jaseg/yanartas-sensors/power/yanartas-pillowbox-power.kicad_pcb

## KiCad design power/yanartas-pillowbox-power.kicad_pcb (2026-11-09)

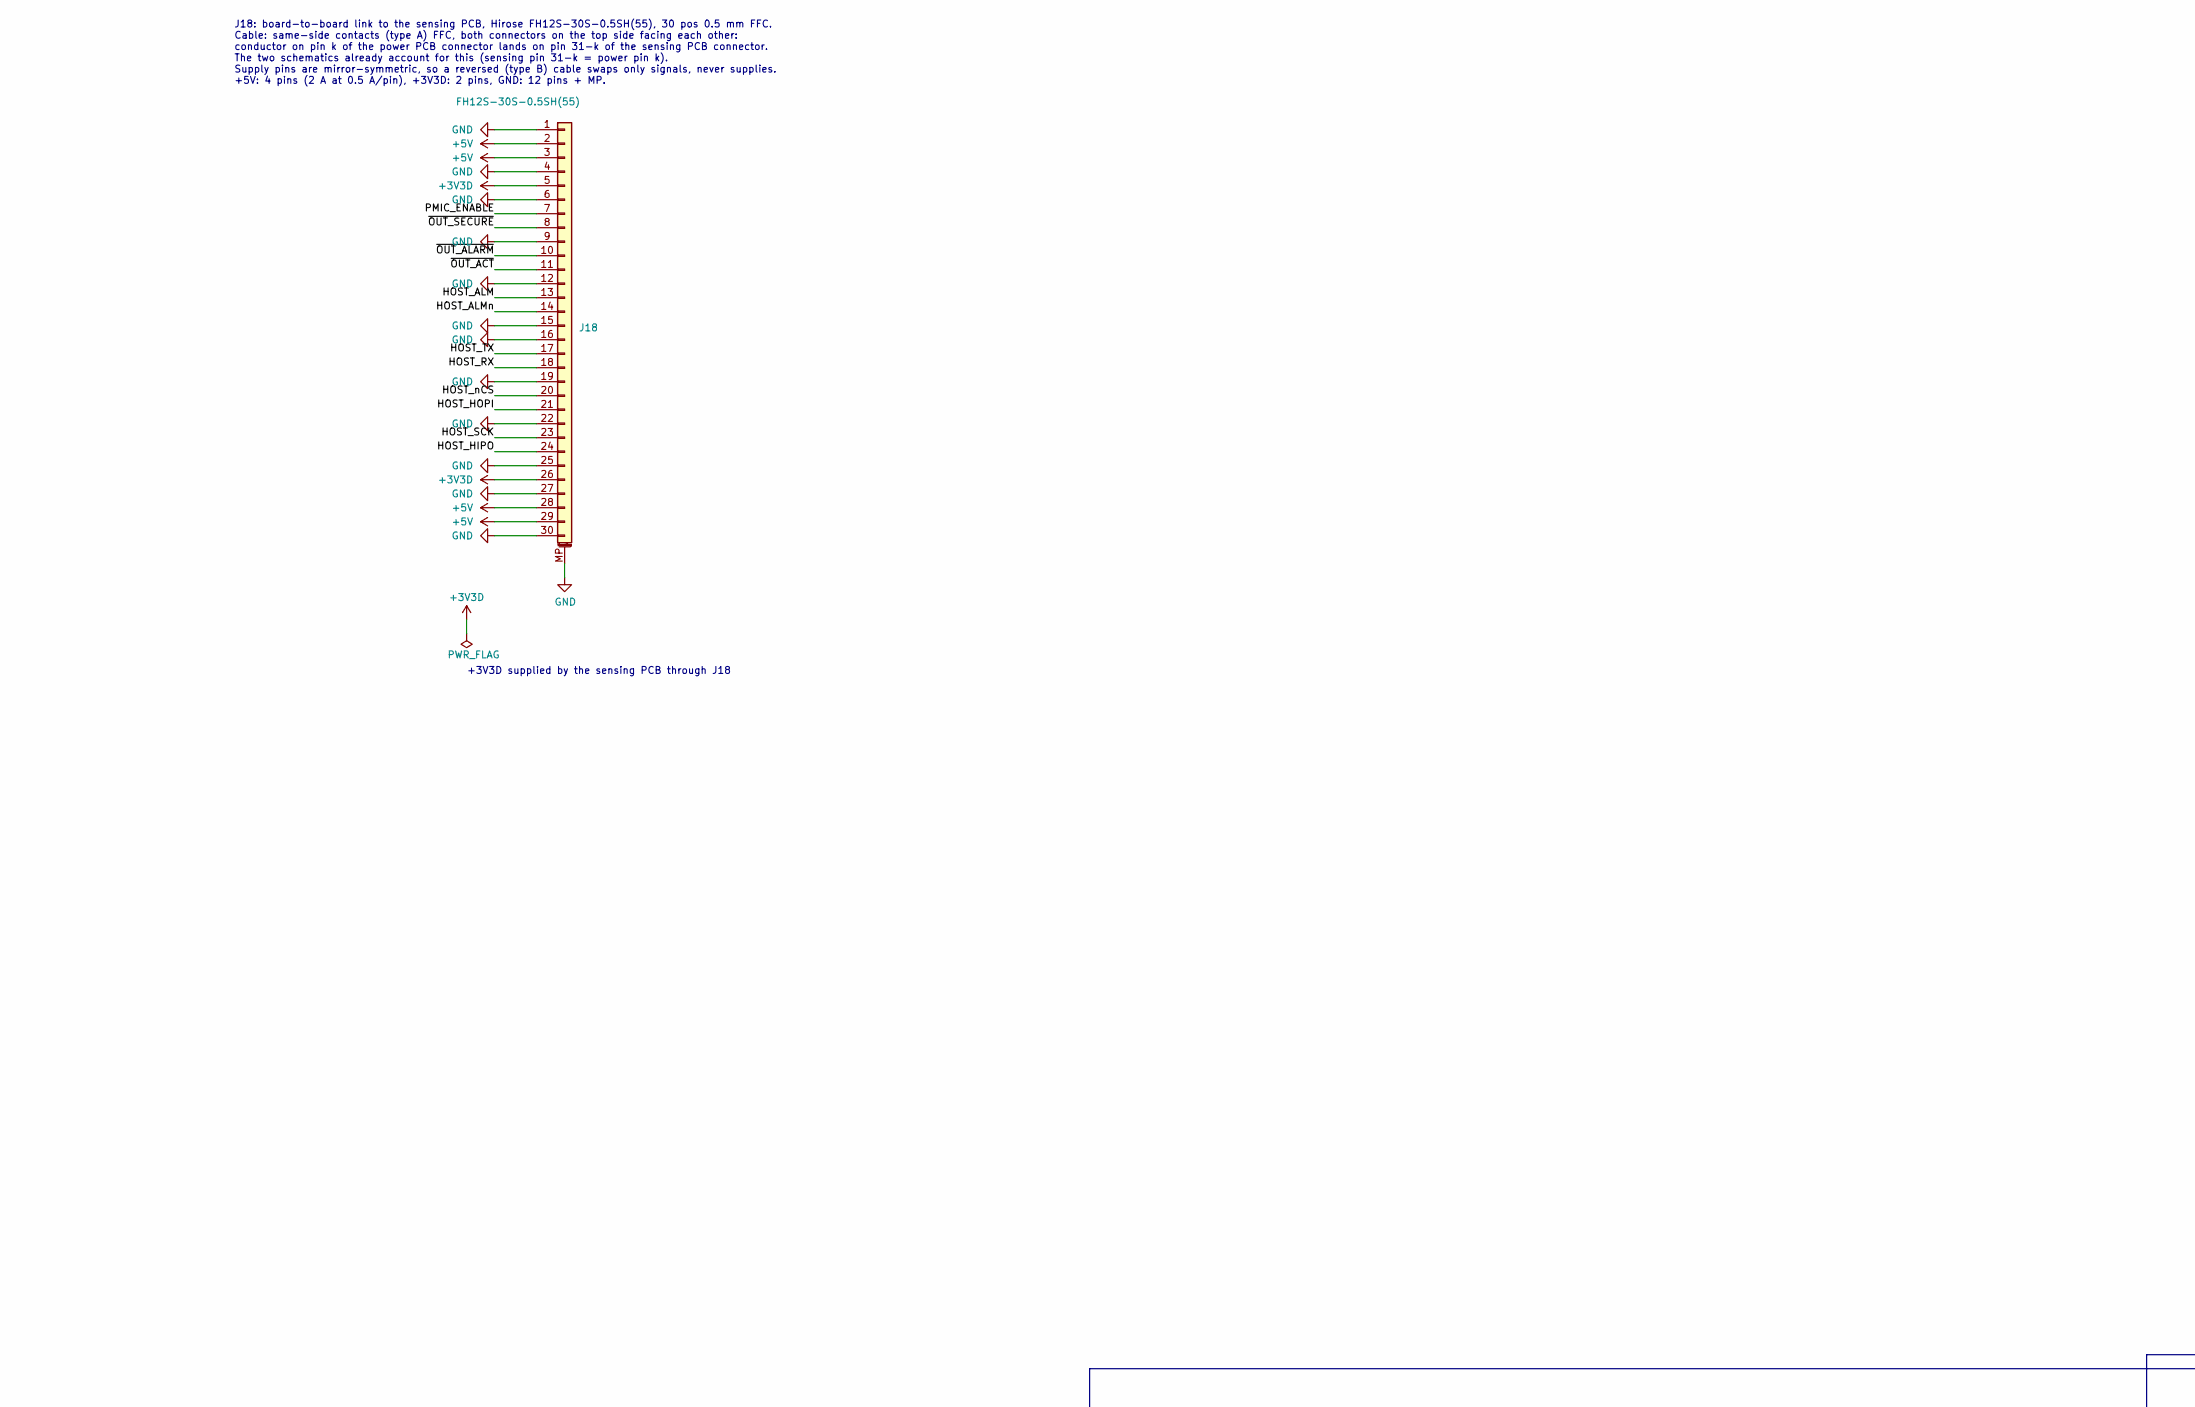
[picture p1: schematic yanartas-pillowbox-power.kicad_sch, part in row 1, column 1]

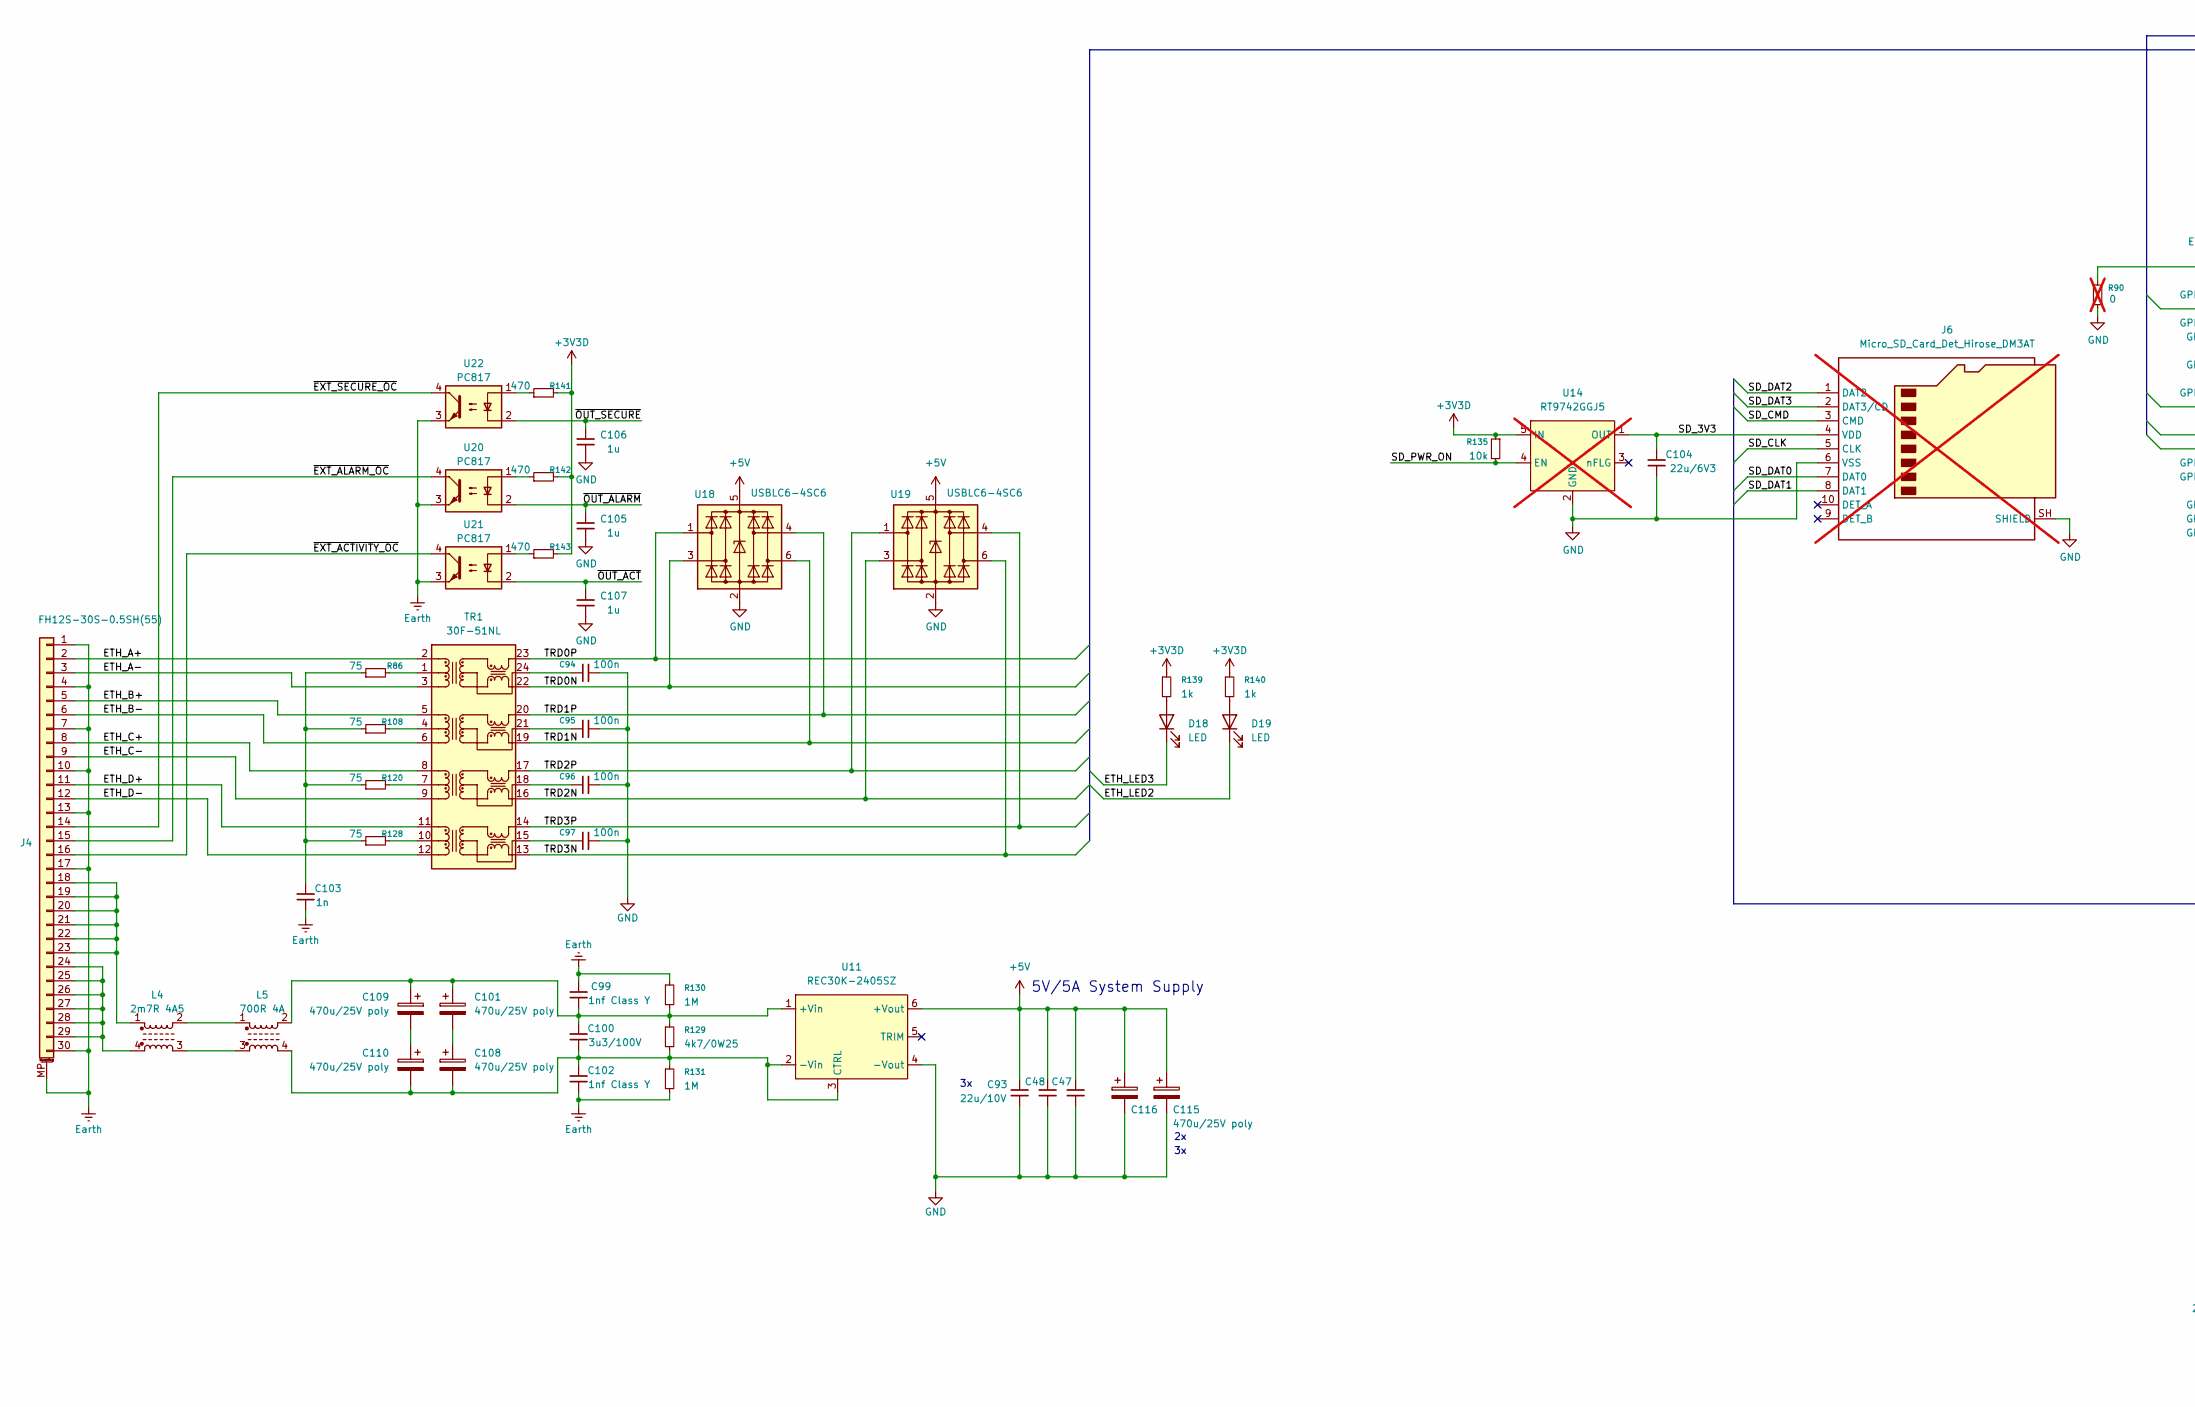
[picture p2: schematic yanartas-pillowbox-power.kicad_sch, part in row 2, column 1]

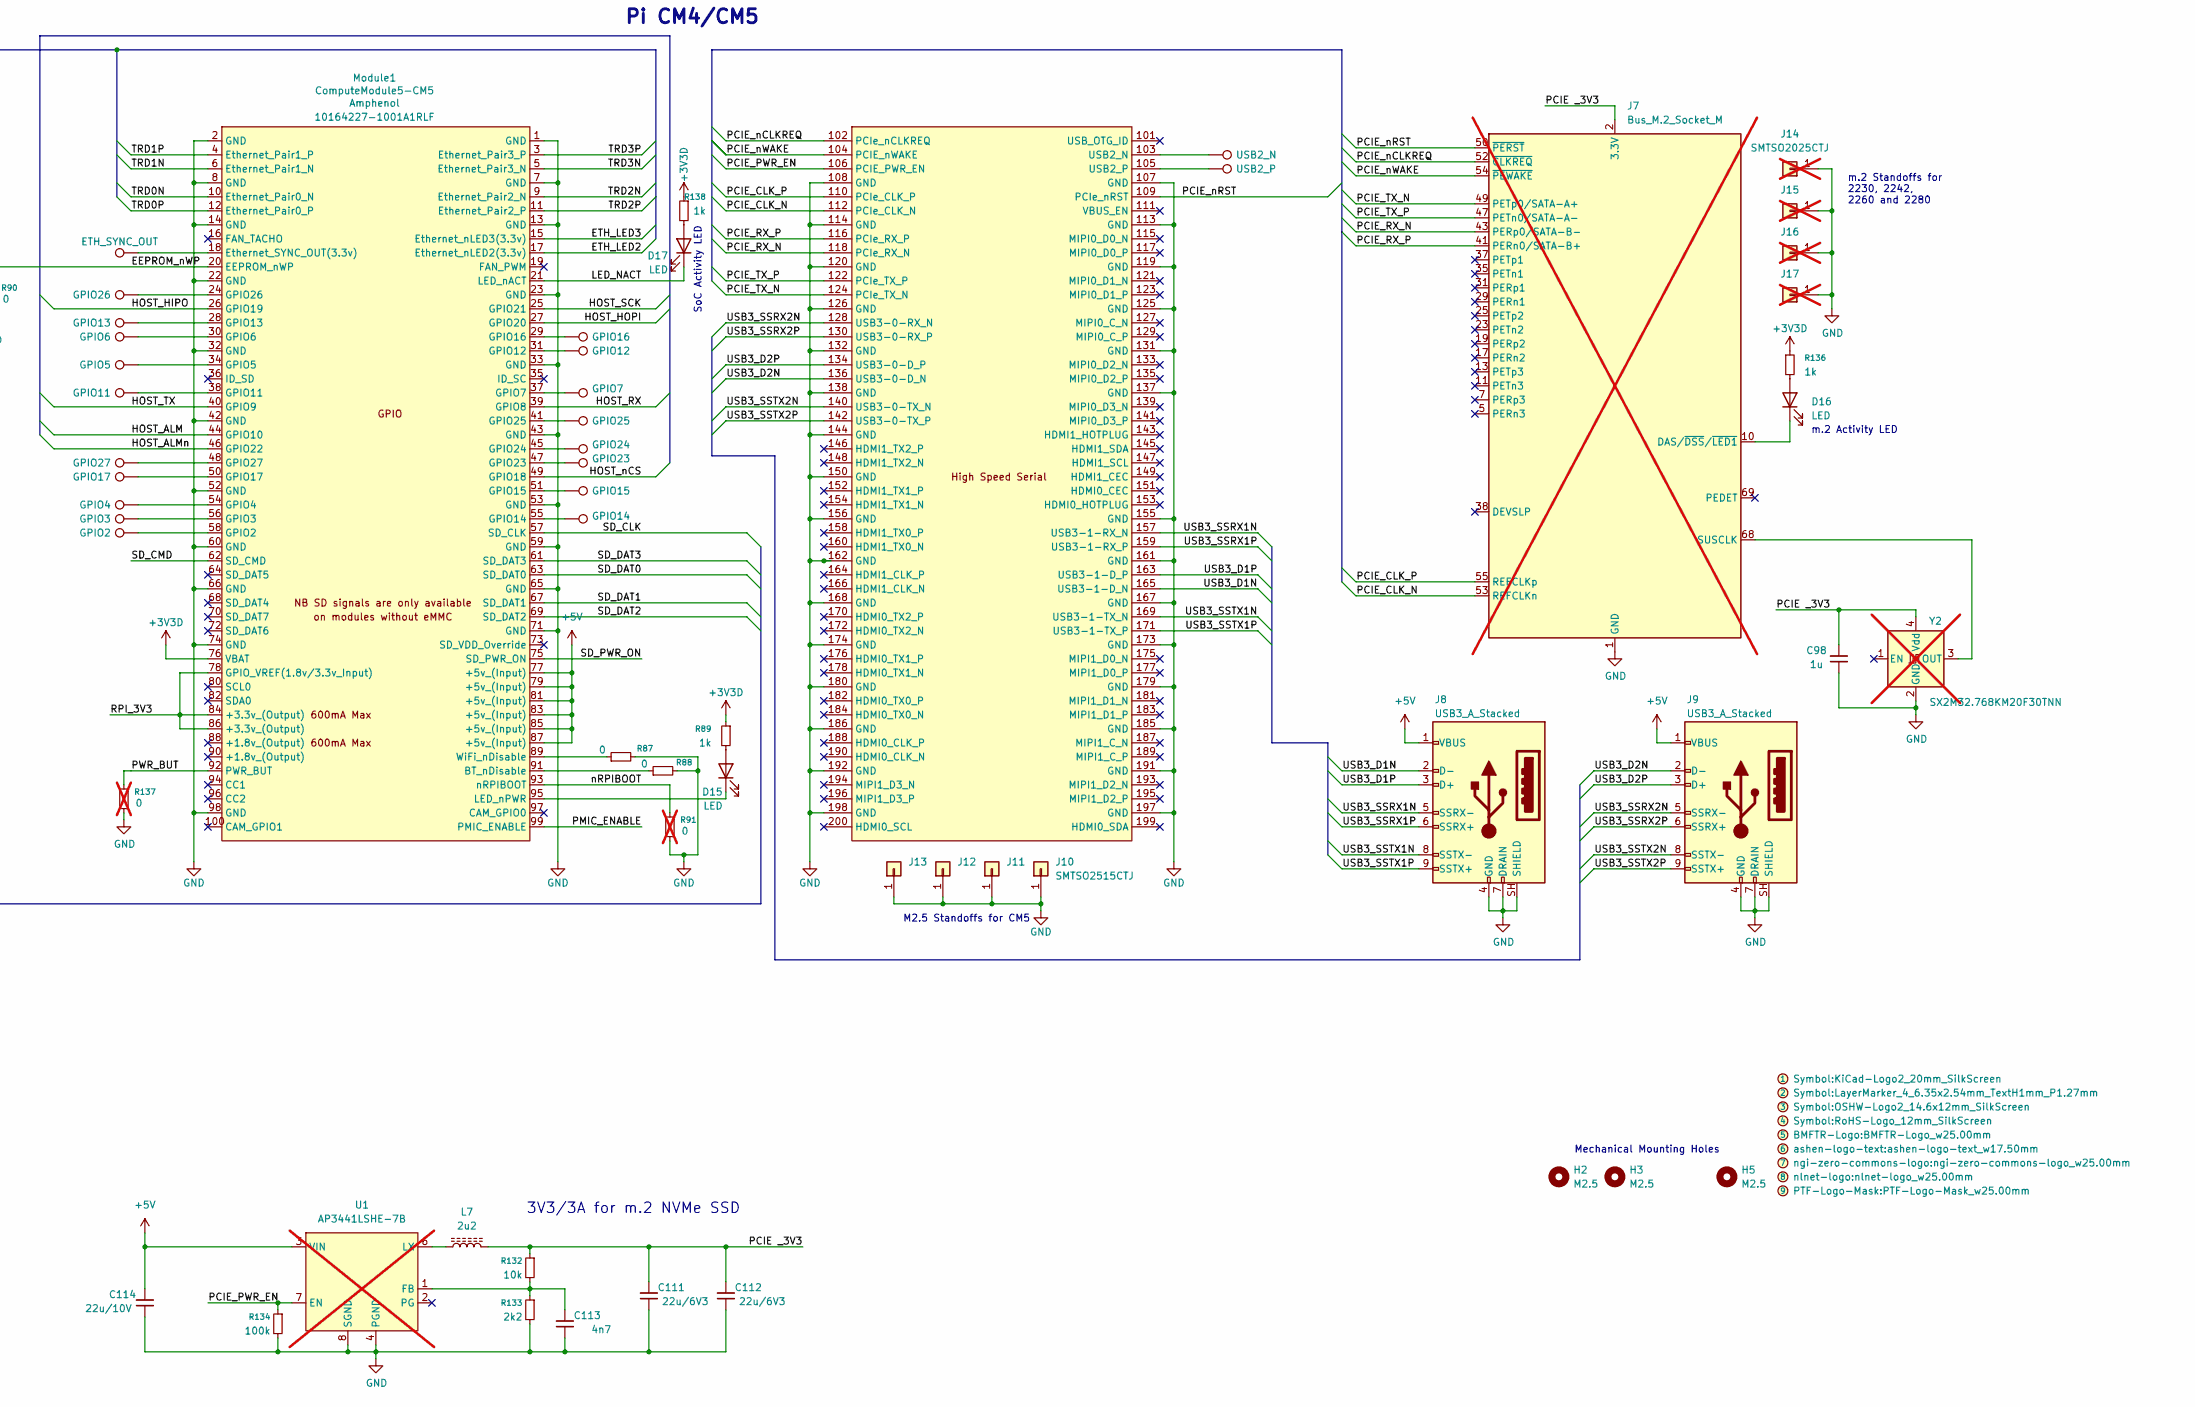
[picture p3: schematic yanartas-pillowbox-power.kicad_sch, part in row 2, column 2]

Parts:
C47, C48, C93, C114: 22u/10V; C_0805_2012Metric; LCSC C45783
C94, C95, C96, C97: 100n; C_0402_1005Metric; LCSC C1525
C98, C105, C106, C107: 1u; C_0402_1005Metric; LCSC C52923
C99, C102: 1nf Class Y; C_Rect_L13.0mm_W4.0mm_P10.00mm_FKS3_FKP3_MKS4; LCSC C361361
C100: 3u3/100V; C_1206_3216Metric; LCSC C695361
C101, C108, C109, C110, C115, C116: 470u/25V poly; CP_Radial_D10.0mm_P5.00mm; MfgPN A750MS477M1EAAE015; LCSC C696345
C103: 1n; C_0603_1608Metric; LCSC C1588
C104, C111, C112: 22u/6V3; C_0805_2012Metric; LCSC C45783
C113: 4n7; C_0402_1005Metric; LCSC C1538
D15, D16, D17, D18, D19: LED; LED_0603_1608Metric; LCSC C2290
H2, H3, H5: M2.5; MountingHole_2.7mm_M2.5; LCSC NA
J4, J18: FH12S-30S-0.5SH(55); Hirose_FH12-30S-0.5SH_1x30-1MP_P0.50mm_Horizontal; LCSC C3169607
J6: Micro_SD_Card_Det_Hirose_DM3AT; microSD_HC_Hirose_DM3AT-SF-PEJM5; MPN DM3AT-SF-PEJM5; LCSC C114218; not fitted
J7: Bus_M.2_Socket_M; CONN-SMD_MDT420M02001; LCSC C2927698; not fitted
J8, J9: USB3_A_Stacked; USB_A_Receptacle_XKB_U231-091N-4BLRA00-S; LCSC C2880618
J10, J11, J12, J13: SMTSO2515CTJ; SINHOO_SMTSO25XX; LCSC C2915629
J14, J15, J16, J17: SMTSO2025CTJ; SINHOO_SMTSO20XX; LCSC C2916321; not fitted
L4: 2m7R 4A5; EPCOS_B82723A; MPN B82723A2402N001; LCSC NA
L5: 700R 4A; TDK_ACM7060; MPN ACM7060-701-2PL-TL01; LCSC C78246
L7: 2u2; CJIANG_FXL0420; LCSC C167206
Module1: ComputeModule5-CM5; Raspberry-Pi-5-Compute-Module-A; Part Description 100 Position Connector Receptacle, Cent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; LCSC C6782225
Module2: ComputeModule5-CM5; Raspberry-Pi-5-Compute-Module-B; Part Description 100 Position Connector Receptacle, Cent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; LCSC C6782225
R86, R108, R120, R128: 75; R_0402_1005Metric; LCSC C25133
R87, R88: 0; R_0402_1005Metric; LCSC C17168
R89, R136, R138, R139, R140: 1k; R_0402_1005Metric; LCSC C11702
R90, R91, R137: 0; R_0402_1005Metric; LCSC C17168; not fitted
R129: 4k7/0W25; R_1206_3216Metric; LCSC C17936
R130, R131: 1M; R_0603_1608Metric; LCSC C22935
R132, R135: 10k; R_0402_1005Metric; LCSC C25744
R133: 2k2; R_0402_1005Metric; LCSC C25879
R134: 100k; R_0402_1005Metric; LCSC C25741
R141, R142, R143: 470; R_0402_1005Metric; LCSC C25117
TP1: GPIO27; TestPoint_Pad_D1.0mm; LCSC NA
TP2: GPIO17; TestPoint_Pad_D1.0mm; LCSC NA
TP3: GPIO4; TestPoint_Pad_D1.0mm; LCSC NA
TP4: GPIO3; TestPoint_Pad_D1.0mm; LCSC NA
TP5: GPIO2; TestPoint_Pad_D1.0mm; LCSC NA
TP6: GPIO11; TestPoint_Pad_D1.0mm; LCSC NA
TP7: GPIO5; TestPoint_Pad_D1.0mm; LCSC NA
TP8: GPIO6; TestPoint_Pad_D1.0mm; LCSC NA
TP9: GPIO13; TestPoint_Pad_D1.0mm; LCSC NA
TP10: GPIO26; TestPoint_Pad_D1.0mm; LCSC NA
TP11: ETH_SYNC_OUT; TestPoint_Pad_D1.0mm; LCSC NA
TP12: GPIO14; TestPoint_Pad_D1.0mm; LCSC NA
TP13: GPIO15; TestPoint_Pad_D1.0mm; LCSC NA
TP14: GPIO23; TestPoint_Pad_D1.0mm; LCSC NA
TP15: GPIO24; TestPoint_Pad_D1.0mm; LCSC NA
TP16: GPIO25; TestPoint_Pad_D1.0mm; LCSC NA
TP17: GPIO7; TestPoint_Pad_D1.0mm; LCSC NA
TP18: GPIO12; TestPoint_Pad_D1.0mm; LCSC NA
TP19: GPIO16; TestPoint_Pad_D1.0mm; LCSC NA
TP20: USB2_N; TestPoint_Pad_D1.0mm; LCSC NA
TP21: USB2_P; TestPoint_Pad_D1.0mm; LCSC NA
TR1: 30F-51NL; Transformer_Ethernet_YDS_30F-51NL_SO-24_7.1x15.1mm; LCSC C123168
U1: AP3441LSHE-7B; DFN-8-1EP_2x2mm_P0.5mm_EP1.05x1.75mm; LCSC C2072094; not fitted
U11: REC30K-2405SZ; RECOM_REC30K-2405SZ; LCSC NA
U14: RT9742GGJ5; SOT-23-5; Part Description Power Switch/Driver 1:1 N-Channel 1A TS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; LCSC C250547; not fitted
U18, U19: USBLC6-4SC6; SOT-23-6; LCSC C558419
U20, U21, U22: PC817; SMDIP-4_W7.62mm; LCSC C41807
Y2: SX2M32.768KM20F30TNN; Crystal_SMD_2520-4Pin_2.5x2.0mm; LCSC C2901603; not fitted

Connections:
+3V3D: J18.5, J18.26, Module1.76 (VBAT), R89.1, R135.1, R136.1, R138.1, R139.1, R140.1, R141.2, R142.2, R143.2, U14.5 (IN)
+5V: C47.2, C48.2, C93.2, C114.2, C115.1, C116.1, J8.1 (VBUS), J9.1 (VBUS), J18.2, J18.3, J18.28, J18.29, Module1.77 (+5v_(Input)), Module1.79 (+5v_(Input)), Module1.81 (+5v_(Input)), Module1.83 (+5v_(Input)), Module1.85 (+5v_(Input)), Module1.87 (+5v_(Input)), U1.3 (VIN), U11.6 (+Vout), U18.5 (VBUS), U19.5 (VBUS)
/EEPROM_nWP: Module1.20 (EEPROM_nWP), R90.2
/ETH_A+: J4.2, TR1.2 (TD1+)
/ETH_A-: J4.3, TR1.3 (TD1-)
/ETH_B+: J4.5, TR1.5 (TD2+)
/ETH_B-: J4.6, TR1.6 (TD2-)
/ETH_C+: J4.8, TR1.8 (TD3+)
/ETH_C-: J4.9, TR1.9 (TD3-)
/ETH_D+: J4.11, TR1.11 (TD4+)
/ETH_D-: J4.12, TR1.12 (TD4-)
/ETH_LED2: D19.1 (K), Module1.17 (Ethernet_nLED2(3.3v))
/ETH_LED3: D18.1 (K), Module1.15 (Ethernet_nLED3(3.3v))
/HOST_ALM: J18.13, Module1.44 (GPIO10)
/HOST_ALMn: J18.14, Module1.46 (GPIO22)
/HOST_HIPO: J18.24, Module1.26 (GPIO19)
/HOST_HOPI: J18.21, Module1.27 (GPIO20)
/HOST_RX: J18.18, Module1.39 (GPIO8)
/HOST_SCK: J18.23, Module1.25 (GPIO21)
/HOST_TX: J18.17, Module1.40 (GPIO9)
/HOST_nCS: J18.20, Module1.49 (GPIO18)
/LED_NACT: D17.1 (K), Module1.21 (LED_nACT)
/PCIE _3V3: C98.2, C111.2, C112.2, J7.2 (3.3V), J7.4 (3.3V), J7.12 (3.3V), J7.14 (3.3V), J7.16 (3.3V), J7.18 (3.3V), J7.70 (3.3V), J7.72 (3.3V), J7.74 (3.3V), L7.2, R132.1, Y2.4 (Vdd)
/PCIE_CLK_N: J7.53 (REFCLKn), Module2.112 (PCIe_CLK_N)
/PCIE_CLK_P: J7.55 (REFCLKp), Module2.110 (PCIe_CLK_P)
/PCIE_PWR_EN: Module2.106 (PCIE_PWR_EN), R134.1, U1.7 (EN)
/PCIE_RX_N: J7.43 (PERp0/SATA-B-), Module2.118 (PCIe_RX_N)
/PCIE_RX_P: J7.41 (PERn0/SATA-B+), Module2.116 (PCIe_RX_P)
/PCIE_TX_N: J7.49 (PETp0/SATA-A+), Module2.124 (PCIe_TX_N)
/PCIE_TX_P: J7.47 (PETn0/SATA-A-), Module2.122 (PCIe_TX_P)
/PCIE_nCLKREQ: J7.52 (~CLKREQ), Module2.102 (PCIe_nCLKREQ)
/PCIE_nRST: J7.50 (~PERST), Module2.109 (PCIe_nRST)
/PCIE_nWAKE: J7.54 (~PEWAKE), Module2.104 (PCIE_nWAKE)
/PMIC_ENABLE: J18.7, Module1.99 (PMIC_ENABLE)
/PWR_BUT: Module1.92 (PWR_BUT), R137.2
/RPI_3V3: Module1.78 (GPIO_VREF(1.8v/3.3v_Input)), Module1.84 (+3.3v_(Output)), Module1.86 (+3.3v_(Output))
/SD_3V3: C104.2, J6.4 (VDD), U14.1 (OUT)
/SD_CLK: J6.5 (CLK), Module1.57 (SD_CLK)
/SD_CMD: J6.3 (CMD), Module1.62 (SD_CMD)
/SD_DAT0: J6.7 (DAT0), Module1.63 (SD_DAT0)
/SD_DAT1: J6.8 (DAT1), Module1.67 (SD_DAT1)
/SD_DAT2: J6.1 (DAT2), Module1.69 (SD_DAT2)
/SD_DAT3: J6.2 (DAT3/CD), Module1.61 (SD_DAT3)
/SD_PWR_ON: Module1.75 (SD_PWR_ON), R135.2, U14.4 (EN)
/TRD0N: Module1.10 (Ethernet_Pair0_N), TR1.22 (MX1-), U18.3 (I/O2)
/TRD0P: Module1.12 (Ethernet_Pair0_P), TR1.23 (MX1+), U18.1 (I/O1)
/TRD1N: Module1.6 (Ethernet_Pair1_N), TR1.19 (MX2-), U18.6 (I/O4)
/TRD1P: Module1.4 (Ethernet_Pair1_P), TR1.20 (MX2+), U18.4 (I/O3)
/TRD2N: Module1.9 (Ethernet_Pair2_N), TR1.16 (MX3-), U19.3 (I/O2)
/TRD2P: Module1.11 (Ethernet_Pair2_P), TR1.17 (MX3+), U19.1 (I/O1)
/TRD3N: Module1.5 (Ethernet_Pair3_N), TR1.13 (MX4-), U19.6 (I/O4)
/TRD3P: Module1.3 (Ethernet_Pair3_P), TR1.14 (MX4+), U19.4 (I/O3)
/USB3_D1N: J8.2 (D-), Module2.165 (USB3-1-D_N)
/USB3_D1P: J8.3 (D+), Module2.163 (USB3-1-D_P)
/USB3_D2N: J9.2 (D-), Module2.136 (USB3-0-D_N)
/USB3_D2P: J9.3 (D+), Module2.134 (USB3-0-D_P)
/USB3_SSRX1N: J8.5 (SSRX-), Module2.157 (USB3-1-RX_N)
/USB3_SSRX1P: J8.6 (SSRX+), Module2.159 (USB3-1-RX_P)
/USB3_SSRX2N: J9.5 (SSRX-), Module2.128 (USB3-0-RX_N)
/USB3_SSRX2P: J9.6 (SSRX+), Module2.130 (USB3-0-RX_P)
/USB3_SSTX1N: J8.8 (SSTX-), Module2.169 (USB3-1-TX_N)
/USB3_SSTX1P: J8.9 (SSTX+), Module2.171 (USB3-1-TX_P)
/USB3_SSTX2N: J9.8 (SSTX-), Module2.140 (USB3-0-TX_N)
/USB3_SSTX2P: J9.9 (SSTX+), Module2.142 (USB3-0-TX_P)
/nRPIBOOT: Module1.93 (nRPIBOOT), R91.2
/~EXT_ACTIVITY_OC: J4.16, U21.4
/~EXT_ALARM_OC: J4.15, U20.4
/~EXT_SECURE_OC: J4.14, U22.4
/~OUT_ACT: C107.2, J18.11, U21.2
/~OUT_ALARM: C105.2, J18.10, U20.2
/~OUT_SECURE: C106.2, J18.8, U22.2
GND: C47.1, C48.1, C93.1, C94.2, C95.2, C96.2, C97.2, C98.1, C104.1, C105.1, C106.1, C107.1, C111.1, C112.1, C113.1, C114.1, C115.2, C116.2, J6.6 (VSS), J6.SH (SHIELD), J7.1 (GND), J7.3 (GND), J7.9 (GND), J7.15 (GND), J7.21 (GND), J7.27 (GND), J7.33 (GND), J7.39 (GND), J7.45 (GND), J7.51 (GND), J7.57 (GND), J7.71 (GND), J7.73 (GND), J7.75 (GND), J8.4 (GND), J8.7 (DRAIN), J8.SH (SHIELD), J9.4 (GND), J9.7 (DRAIN), J9.SH (SHIELD), J10.1 (Pin_1_1), J11.1 (Pin_1_1), J12.1 (Pin_1_1), J13.1 (Pin_1_1), J14.1 (Pin_1_1), J15.1 (Pin_1_1), J16.1 (Pin_1_1), J17.1 (Pin_1_1), J18.1, J18.4, J18.6, J18.9, J18.12, J18.15, J18.16, J18.19, J18.22, J18.25, J18.27, J18.30, J18.MP (MountPin), Module1.1 (GND), Module1.2 (GND), Module1.7 (GND), Module1.8 (GND), Module1.13 (GND), Module1.14 (GND), Module1.22 (GND), Module1.23 (GND), Module1.32 (GND), Module1.33 (GND), Module1.42 (GND), Module1.43 (GND), Module1.52 (GND), Module1.53 (GND), Module1.59 (GND), Module1.60 (GND), Module1.65 (GND), Module1.66 (GND), Module1.71 (GND), Module1.74 (GND), Module1.98 (GND), Module2.107 (GND), Module2.108 (GND), Module2.113 (GND), Module2.114 (GND), Module2.119 (GND), Module2.120 (GND), Module2.125 (GND), Module2.126 (GND), Module2.131 (GND), Module2.132 (GND), Module2.137 (GND), Module2.138 (GND), Module2.144 (GND), Module2.150 (GND), Module2.155 (GND), Module2.156 (GND), Module2.161 (GND), Module2.162 (GND), Module2.167 (GND), Module2.168 (GND), Module2.173 (GND), Module2.174 (GND), Module2.179 (GND), Module2.180 (GND), Module2.185 (GND), Module2.186 (GND), Module2.191 (GND), Module2.192 (GND), Module2.197 (GND), Module2.198 (GND), R87.2, R88.2, R90.1, R91.1, R133.2, R134.2, R137.1, U1.4 (PGND), U1.8 (SGND), U1.9 (PAD), U11.4 (-Vout), U14.2 (GND), U18.2 (GND), U19.2 (GND), Y2.2 (GND)
unnamed: C94.1, TR1.24 (CT)
unnamed: C95.1, TR1.21 (CT)
unnamed: C96.1, TR1.18 (CT)
unnamed: C97.1, TR1.15 (CT)
unnamed: C101.2, C108.1
unnamed: C103.2, R86.1, R108.1, R120.1, R128.1
unnamed: C109.2, C110.1
unnamed: D15.2 (A), R89.2
unnamed: D15.1 (K), Module1.95 (LED_nPWR)
unnamed: D16.2 (A), R136.2
unnamed: D16.1 (K), J7.10 (DAS/~DSS/~LED1)
unnamed: D17.2 (A), R138.2
unnamed: D18.2 (A), R139.2
unnamed: D19.2 (A), R140.2
unnamed: J7.68 (SUSCLK), Y2.3 (OUT)
unnamed: L4.2, L5.1
unnamed: L4.3, L5.3
unnamed: Module1.91 (BT_nDisable), R88.1
unnamed: Module1.18 (Ethernet_SYNC_OUT(3.3v)), TP11.1 (1_1)
unnamed: Module1.58 (GPIO2), TP5.1 (1_1)
unnamed: Module1.56 (GPIO3), TP4.1 (1_1)
unnamed: Module1.54 (GPIO4), TP3.1 (1_1)
unnamed: Module1.34 (GPIO5), TP7.1 (1_1)
unnamed: Module1.30 (GPIO6), TP8.1 (1_1)
unnamed: Module1.37 (GPIO7), TP17.1 (1_1)
unnamed: Module1.38 (GPIO11), TP6.1 (1_1)
unnamed: Module1.31 (GPIO12), TP18.1 (1_1)
unnamed: Module1.28 (GPIO13), TP9.1 (1_1)
unnamed: Module1.55 (GPIO14), TP12.1 (1_1)
unnamed: Module1.51 (GPIO15), TP13.1 (1_1)
unnamed: Module1.29 (GPIO16), TP19.1 (1_1)
unnamed: Module1.50 (GPIO17), TP2.1 (1_1)
unnamed: Module1.47 (GPIO23), TP14.1 (1_1)
unnamed: Module1.45 (GPIO24), TP15.1 (1_1)
unnamed: Module1.41 (GPIO25), TP16.1 (1_1)
unnamed: Module1.24 (GPIO26), TP10.1 (1_1)
unnamed: Module1.48 (GPIO27), TP1.1 (1_1)
unnamed: Module1.89 (WiFi_nDisable), R87.1
unnamed: Module2.103 (USB2_N), TP20.1 (1_1)
unnamed: Module2.105 (USB2_P), TP21.1 (1_1)
unnamed: R86.2, TR1.1 (CT)
unnamed: R108.2, TR1.4 (CT)
unnamed: R120.2, TR1.7 (CT)
unnamed: R128.2, TR1.10 (CT)
unnamed: R141.1, U22.1
unnamed: R142.1, U20.1
unnamed: R143.1, U21.1
unnamed: C113.2, R132.2, R133.1, U1.1 (FB)
unnamed: L7.1, U1.6 (LX)
unnamed: C99.1, C100.2, C101.1, C109.1, L5.2, R129.1, R130.2, U11.1 (+Vin)
unnamed: C100.1, C102.2, C108.2, C110.2, L5.4, R129.2, R131.1, U11.2 (-Vin), U11.3 (CTRL)

Notes on the sheet:
m.2 Standoffs for 2230, 2242, 2260 and 2280
SoC Activity LED
Pi CM4/CM5
M2.5 Standoffs for CM5
5V/5A System Supply
Mechanical Mounting Holes
m.2 Activity LED
3V3/3A for m.2 NVMe SSD
J18: board-to-board link to the sensing PCB, Hirose FH12S-30S-0.5SH(55), 30 pos 0.5 mm FFC. Cable: same-side contacts (type A) FFC, both connectors on the top side facing each other: conductor on pin k of the power PCB connector lands on pin 31-k of the sensing PCB connector. The two schematics alr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
+3V3D supplied by the sensing PCB through J18

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
Board: 2 copper layers, 107 parts (6 on the bottom side), 117 nets, no tracks yet.
