jaseg/yanartas-sensors/sensing/yanartas-pillowbox-sensing.kicad_pcb

## KiCad design sensing/yanartas-pillowbox-sensing.kicad_pcb (2026-11-09)

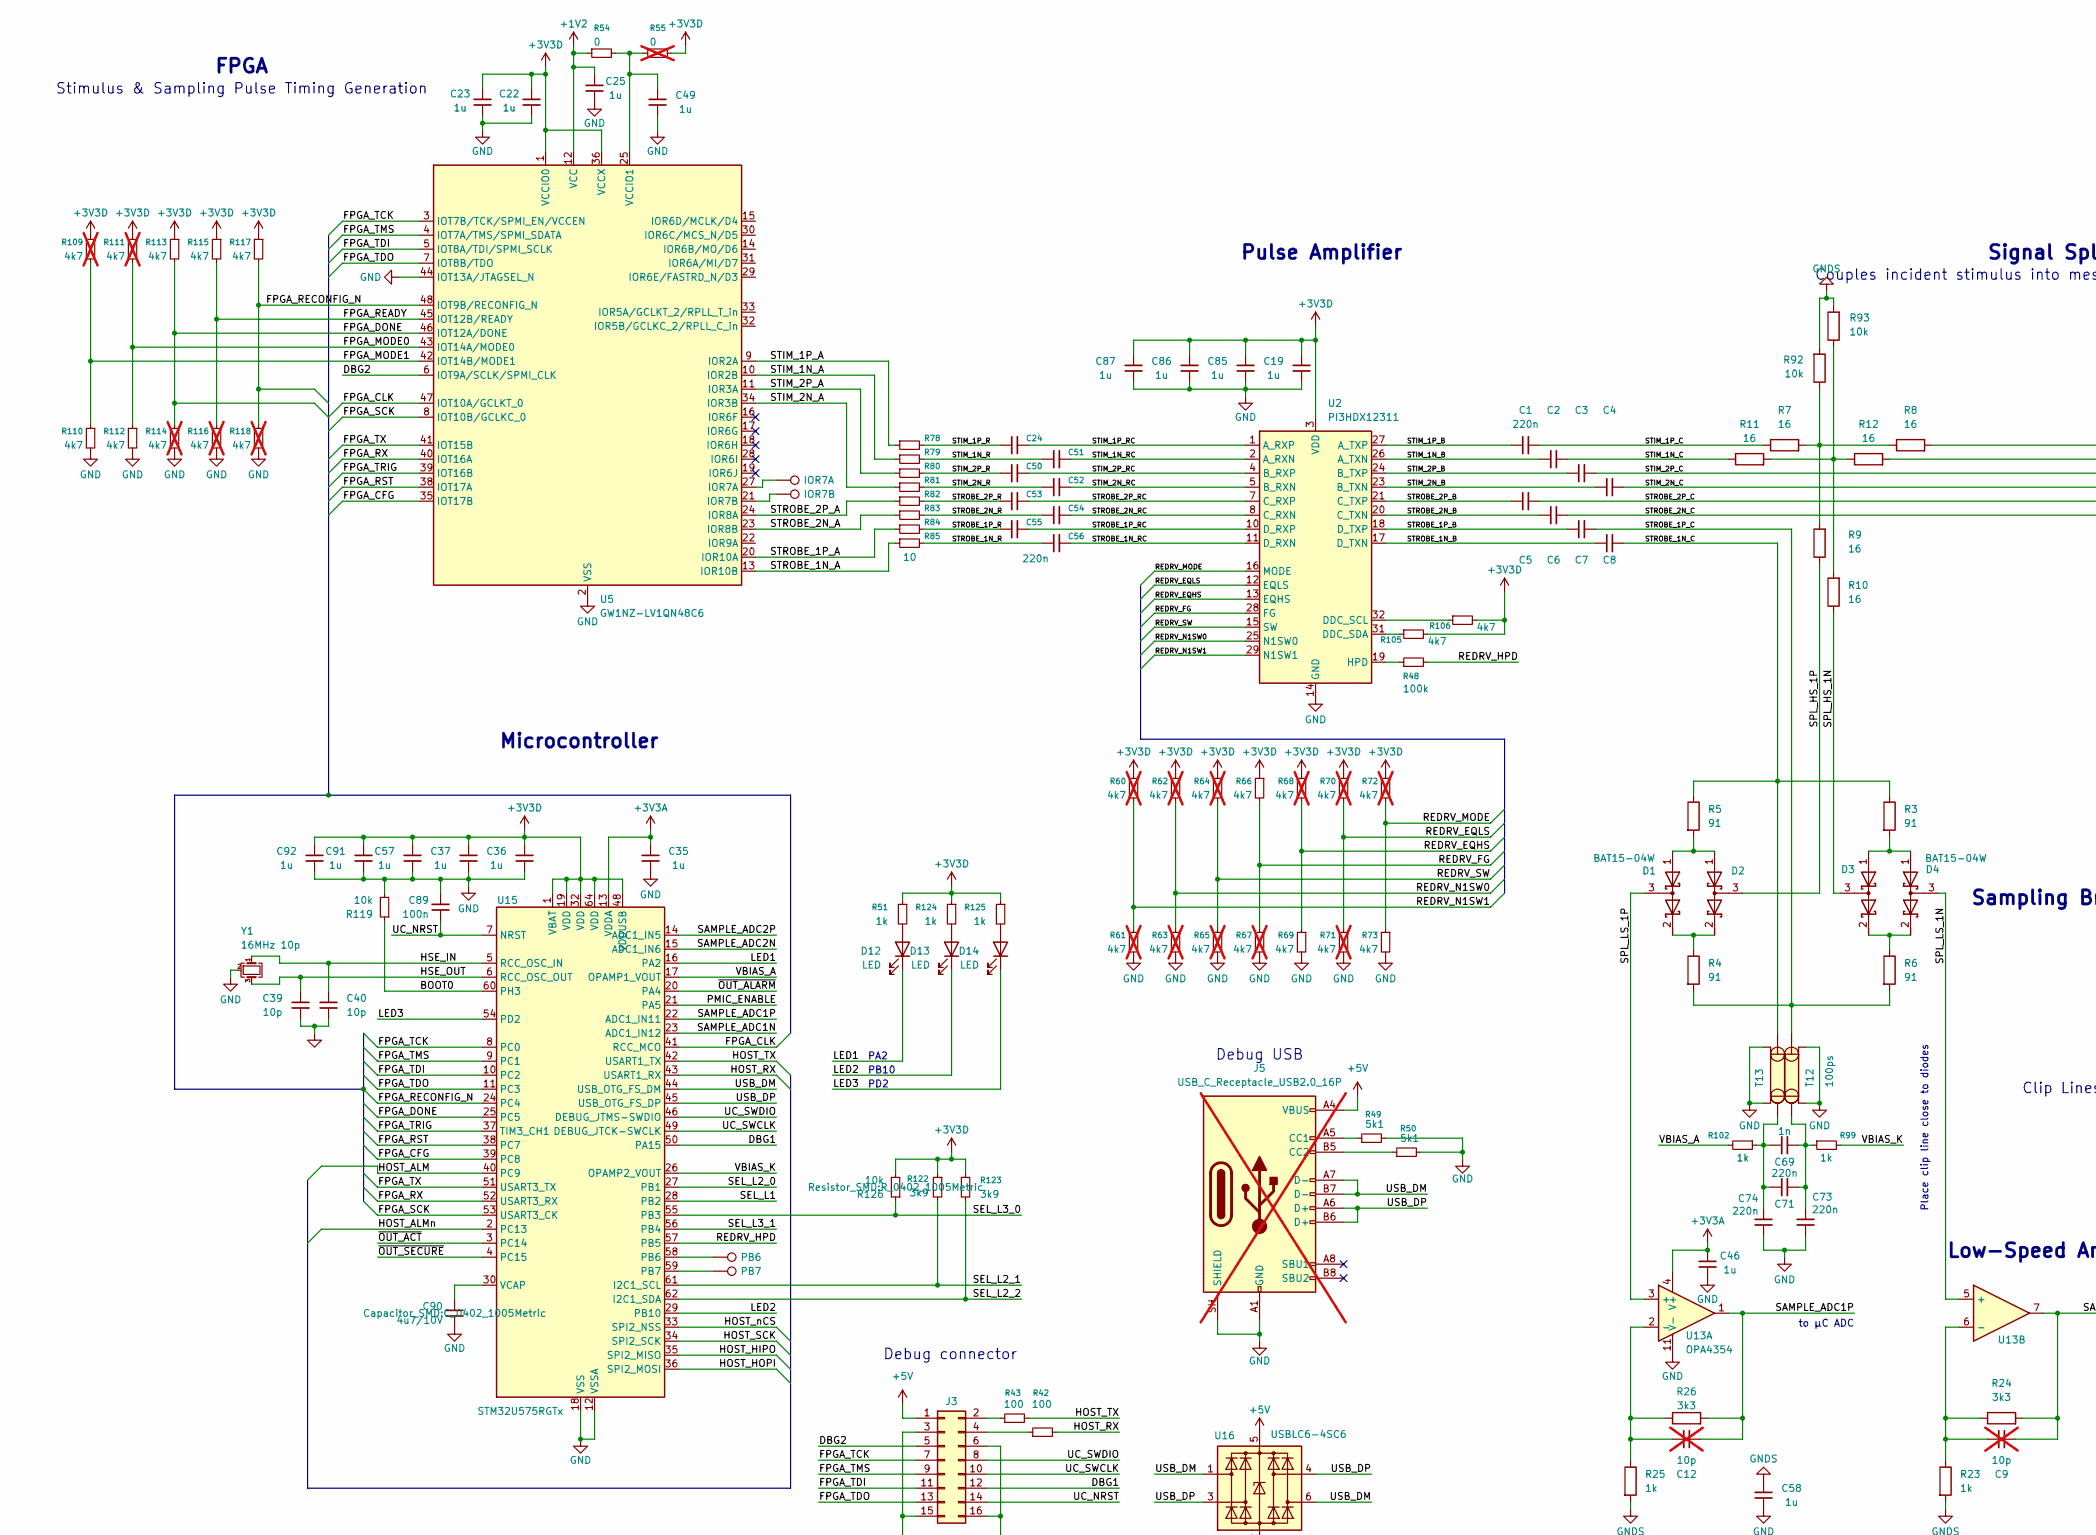
[picture p4: schematic yanartas-pillowbox-sensing.kicad_sch, part in row 1, column 1]

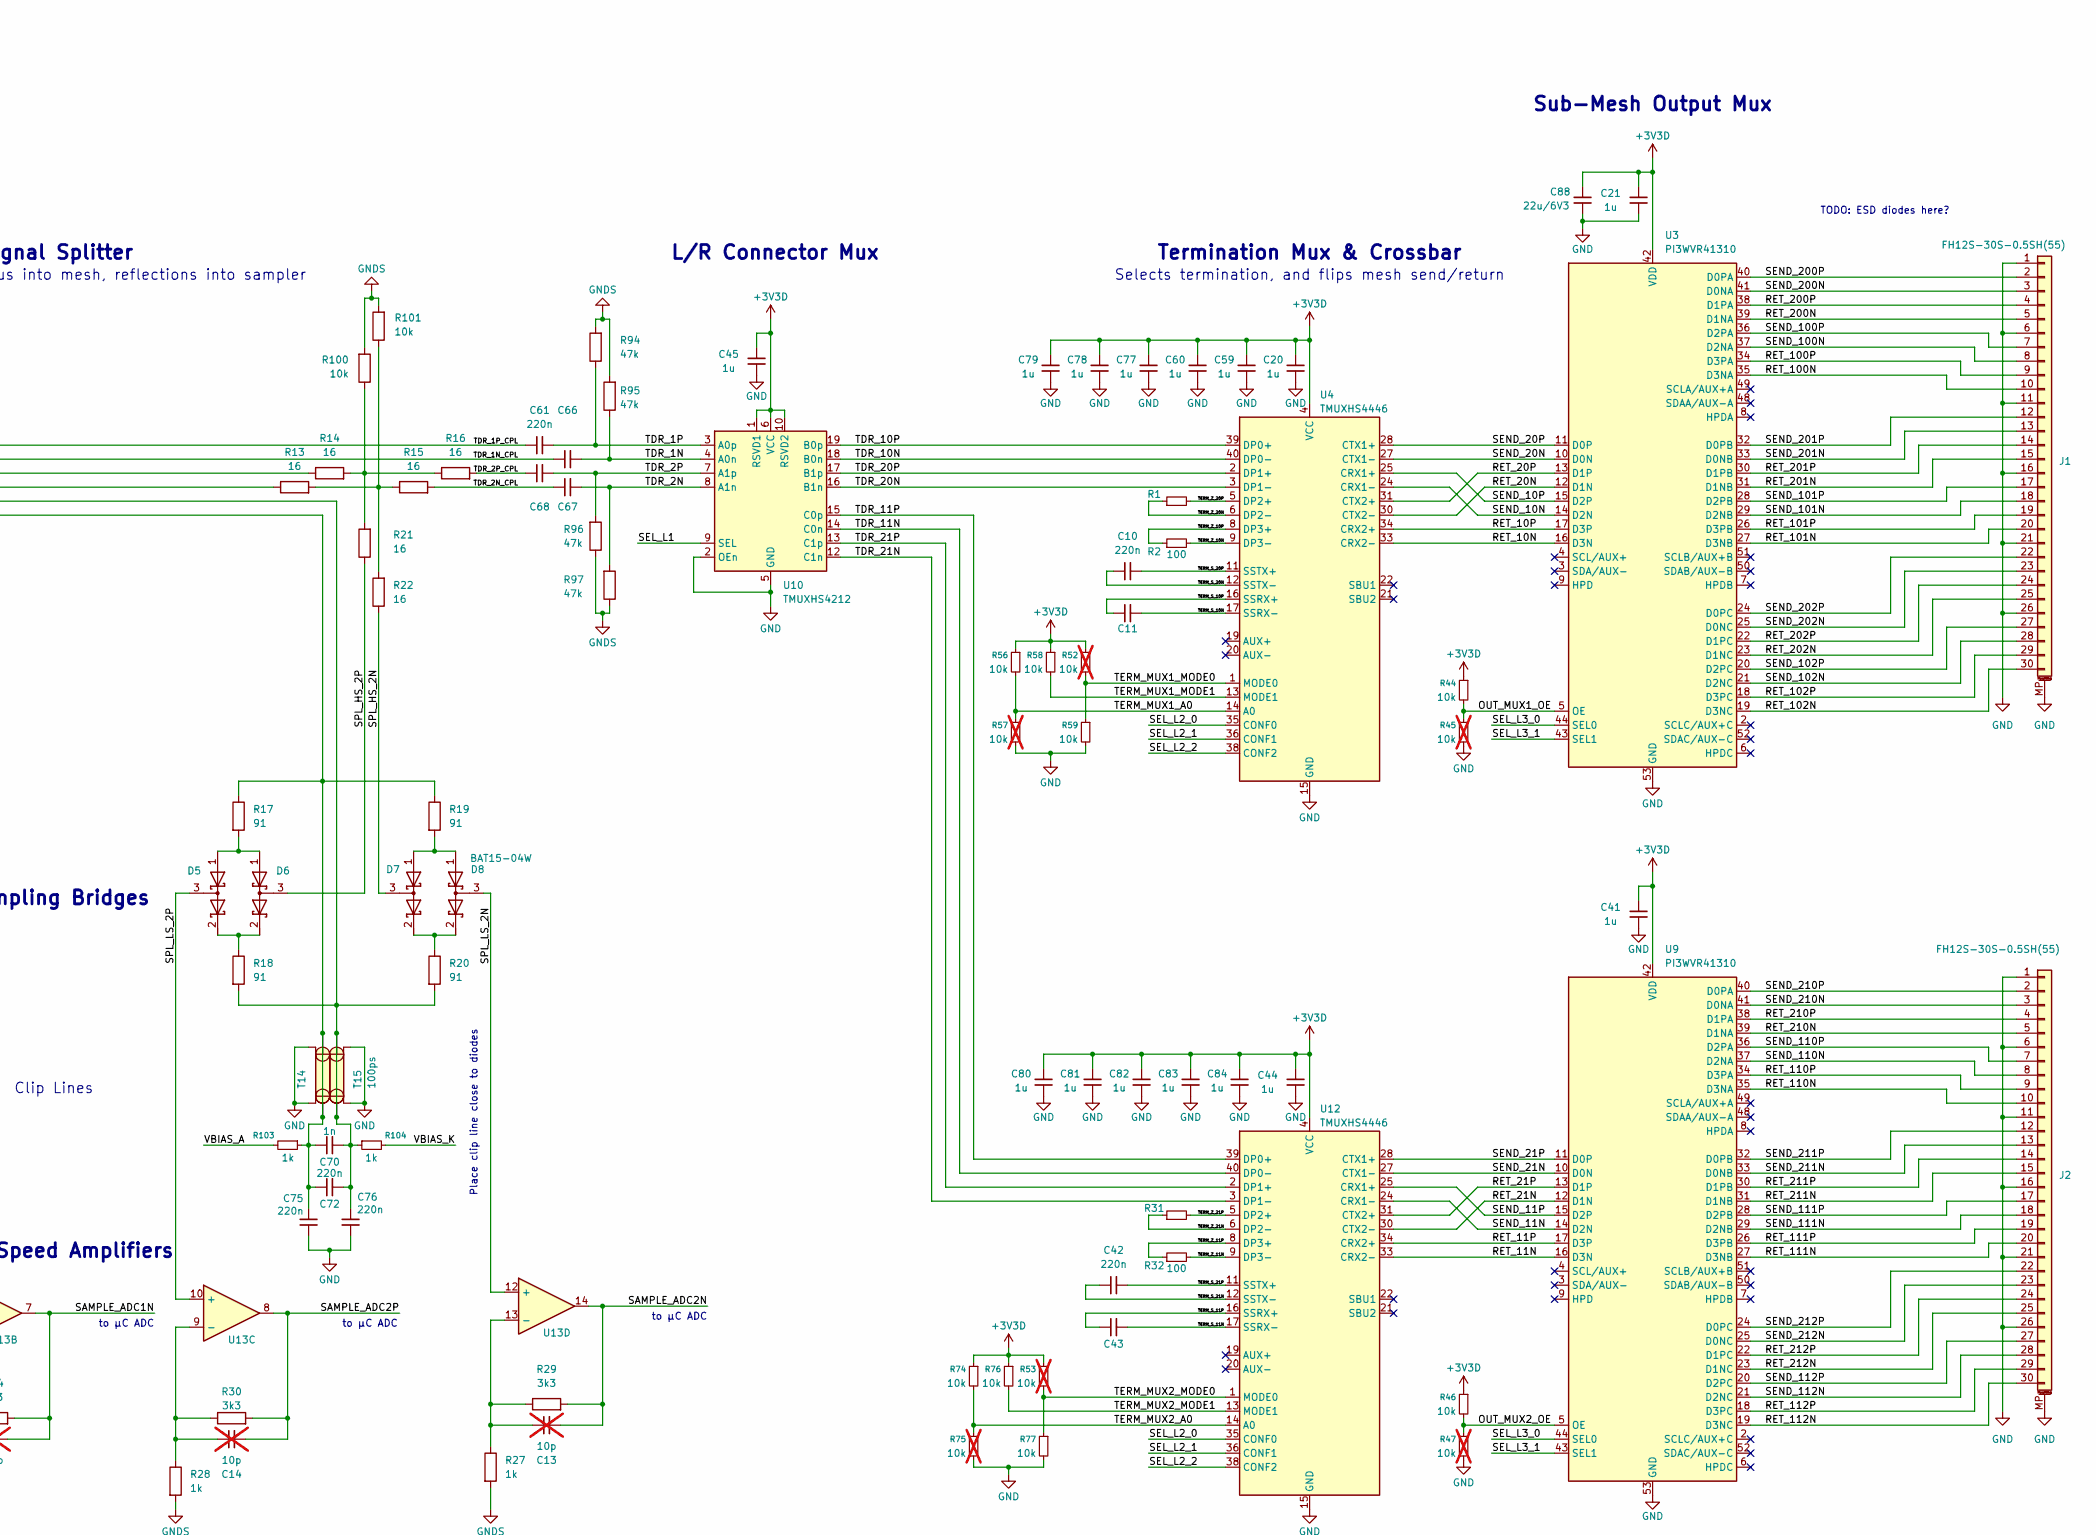
[picture p5: schematic yanartas-pillowbox-sensing.kicad_sch, part in row 1, column 2]

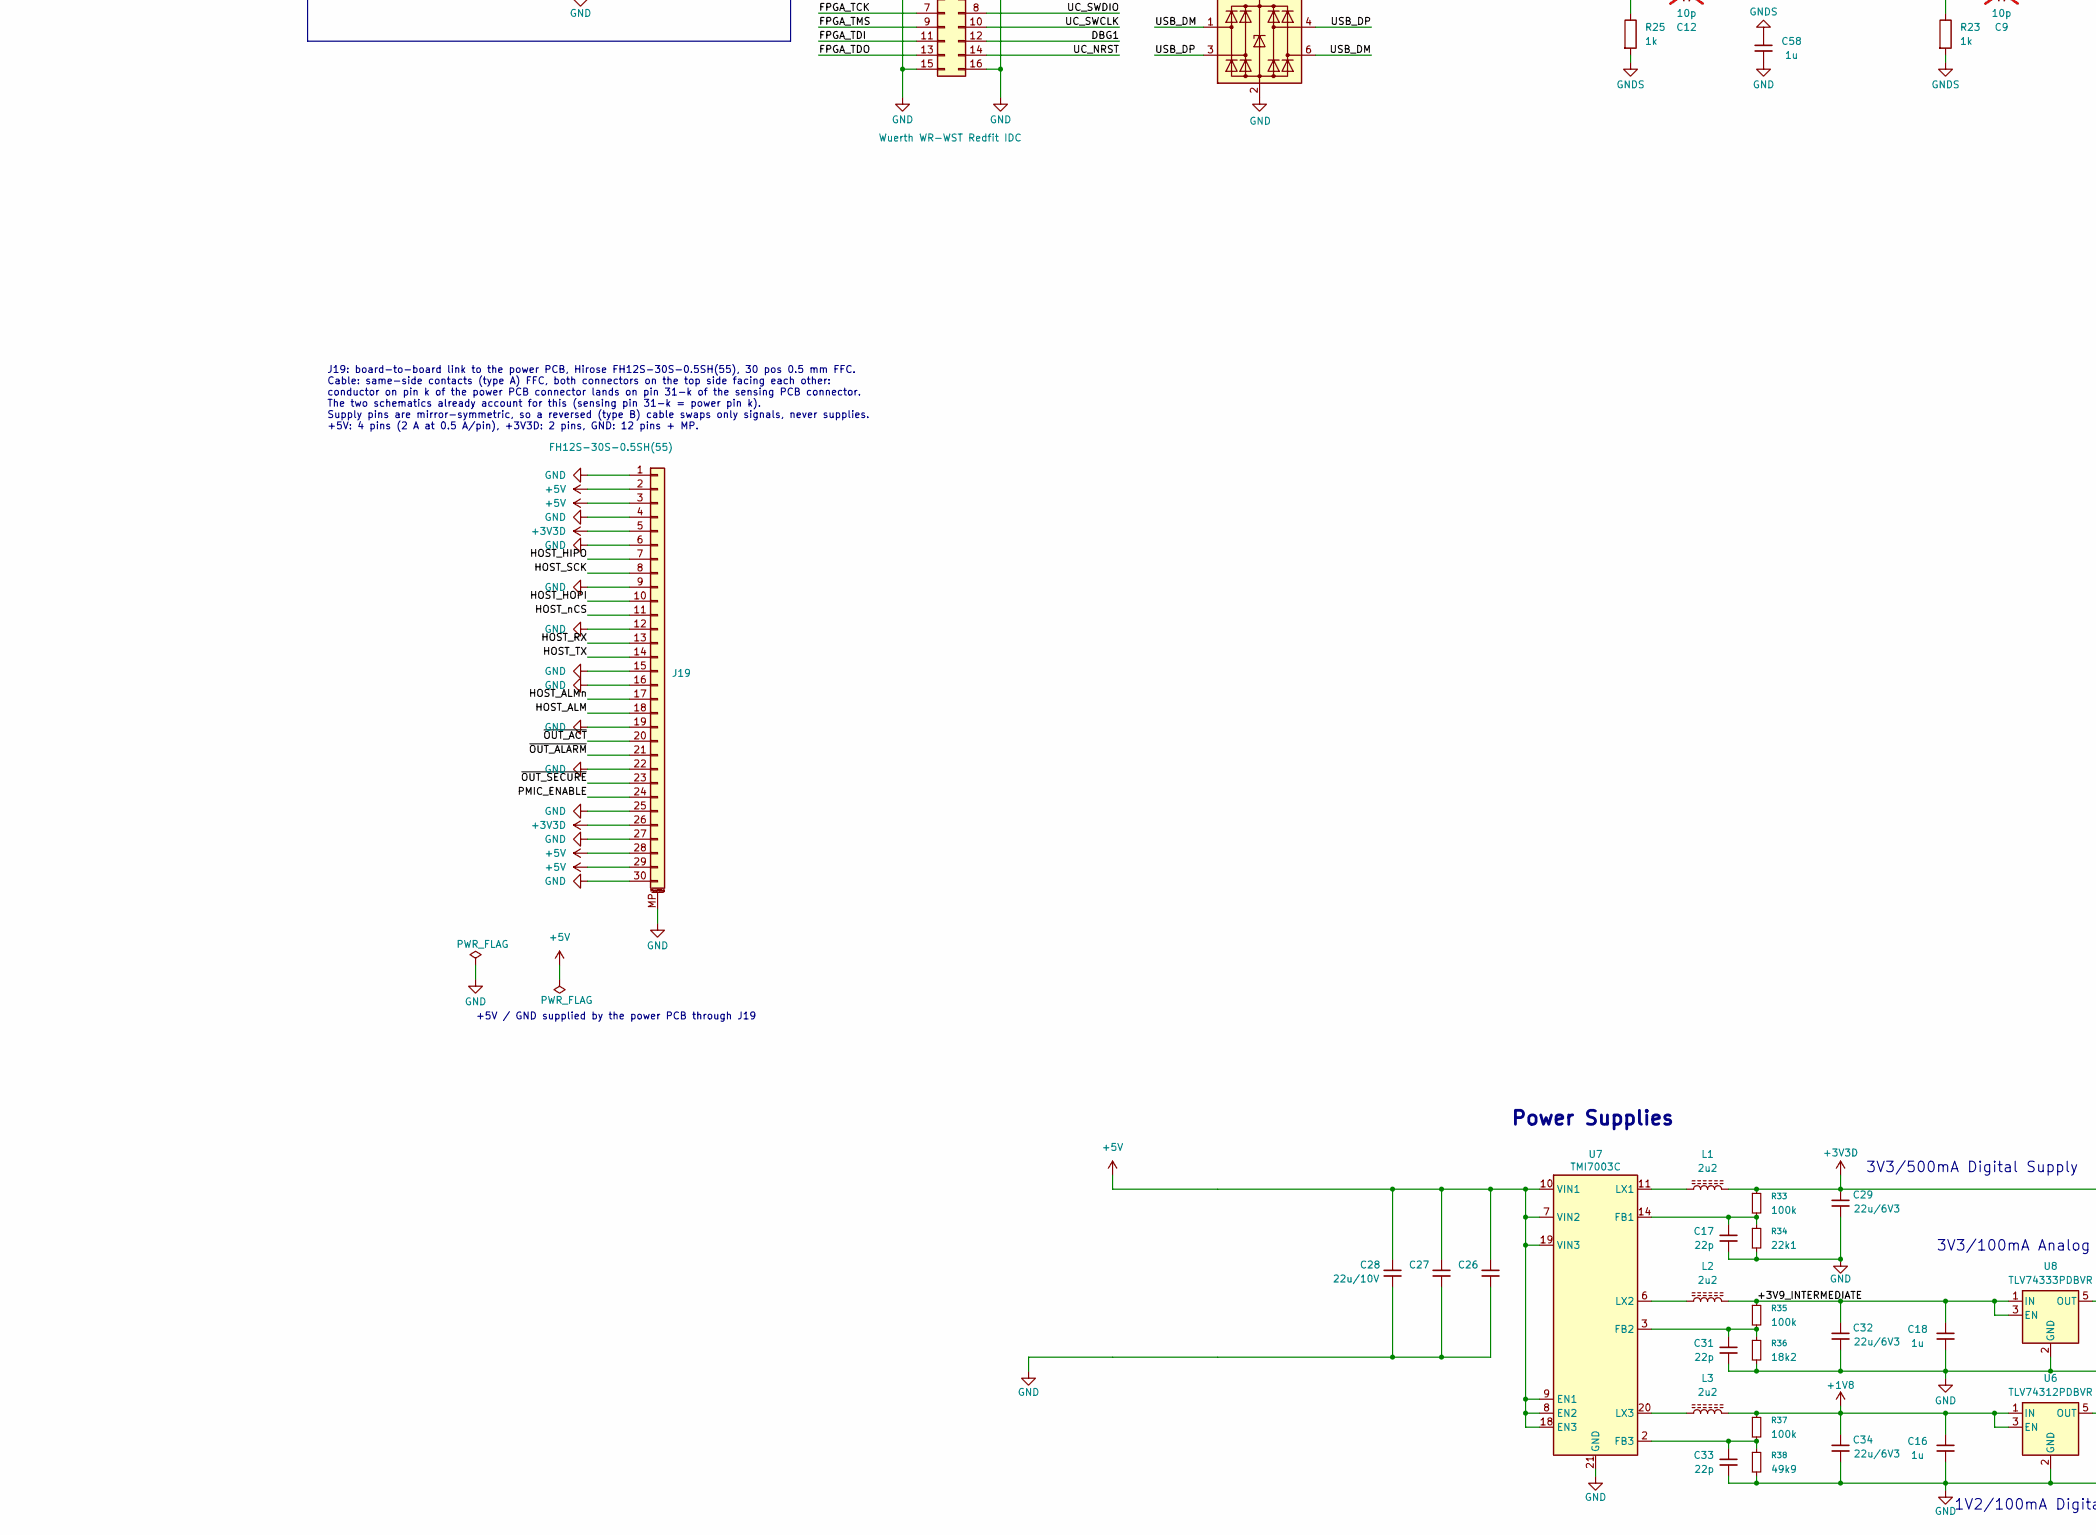
[picture p6: schematic yanartas-pillowbox-sensing.kicad_sch, part in row 2, column 1]

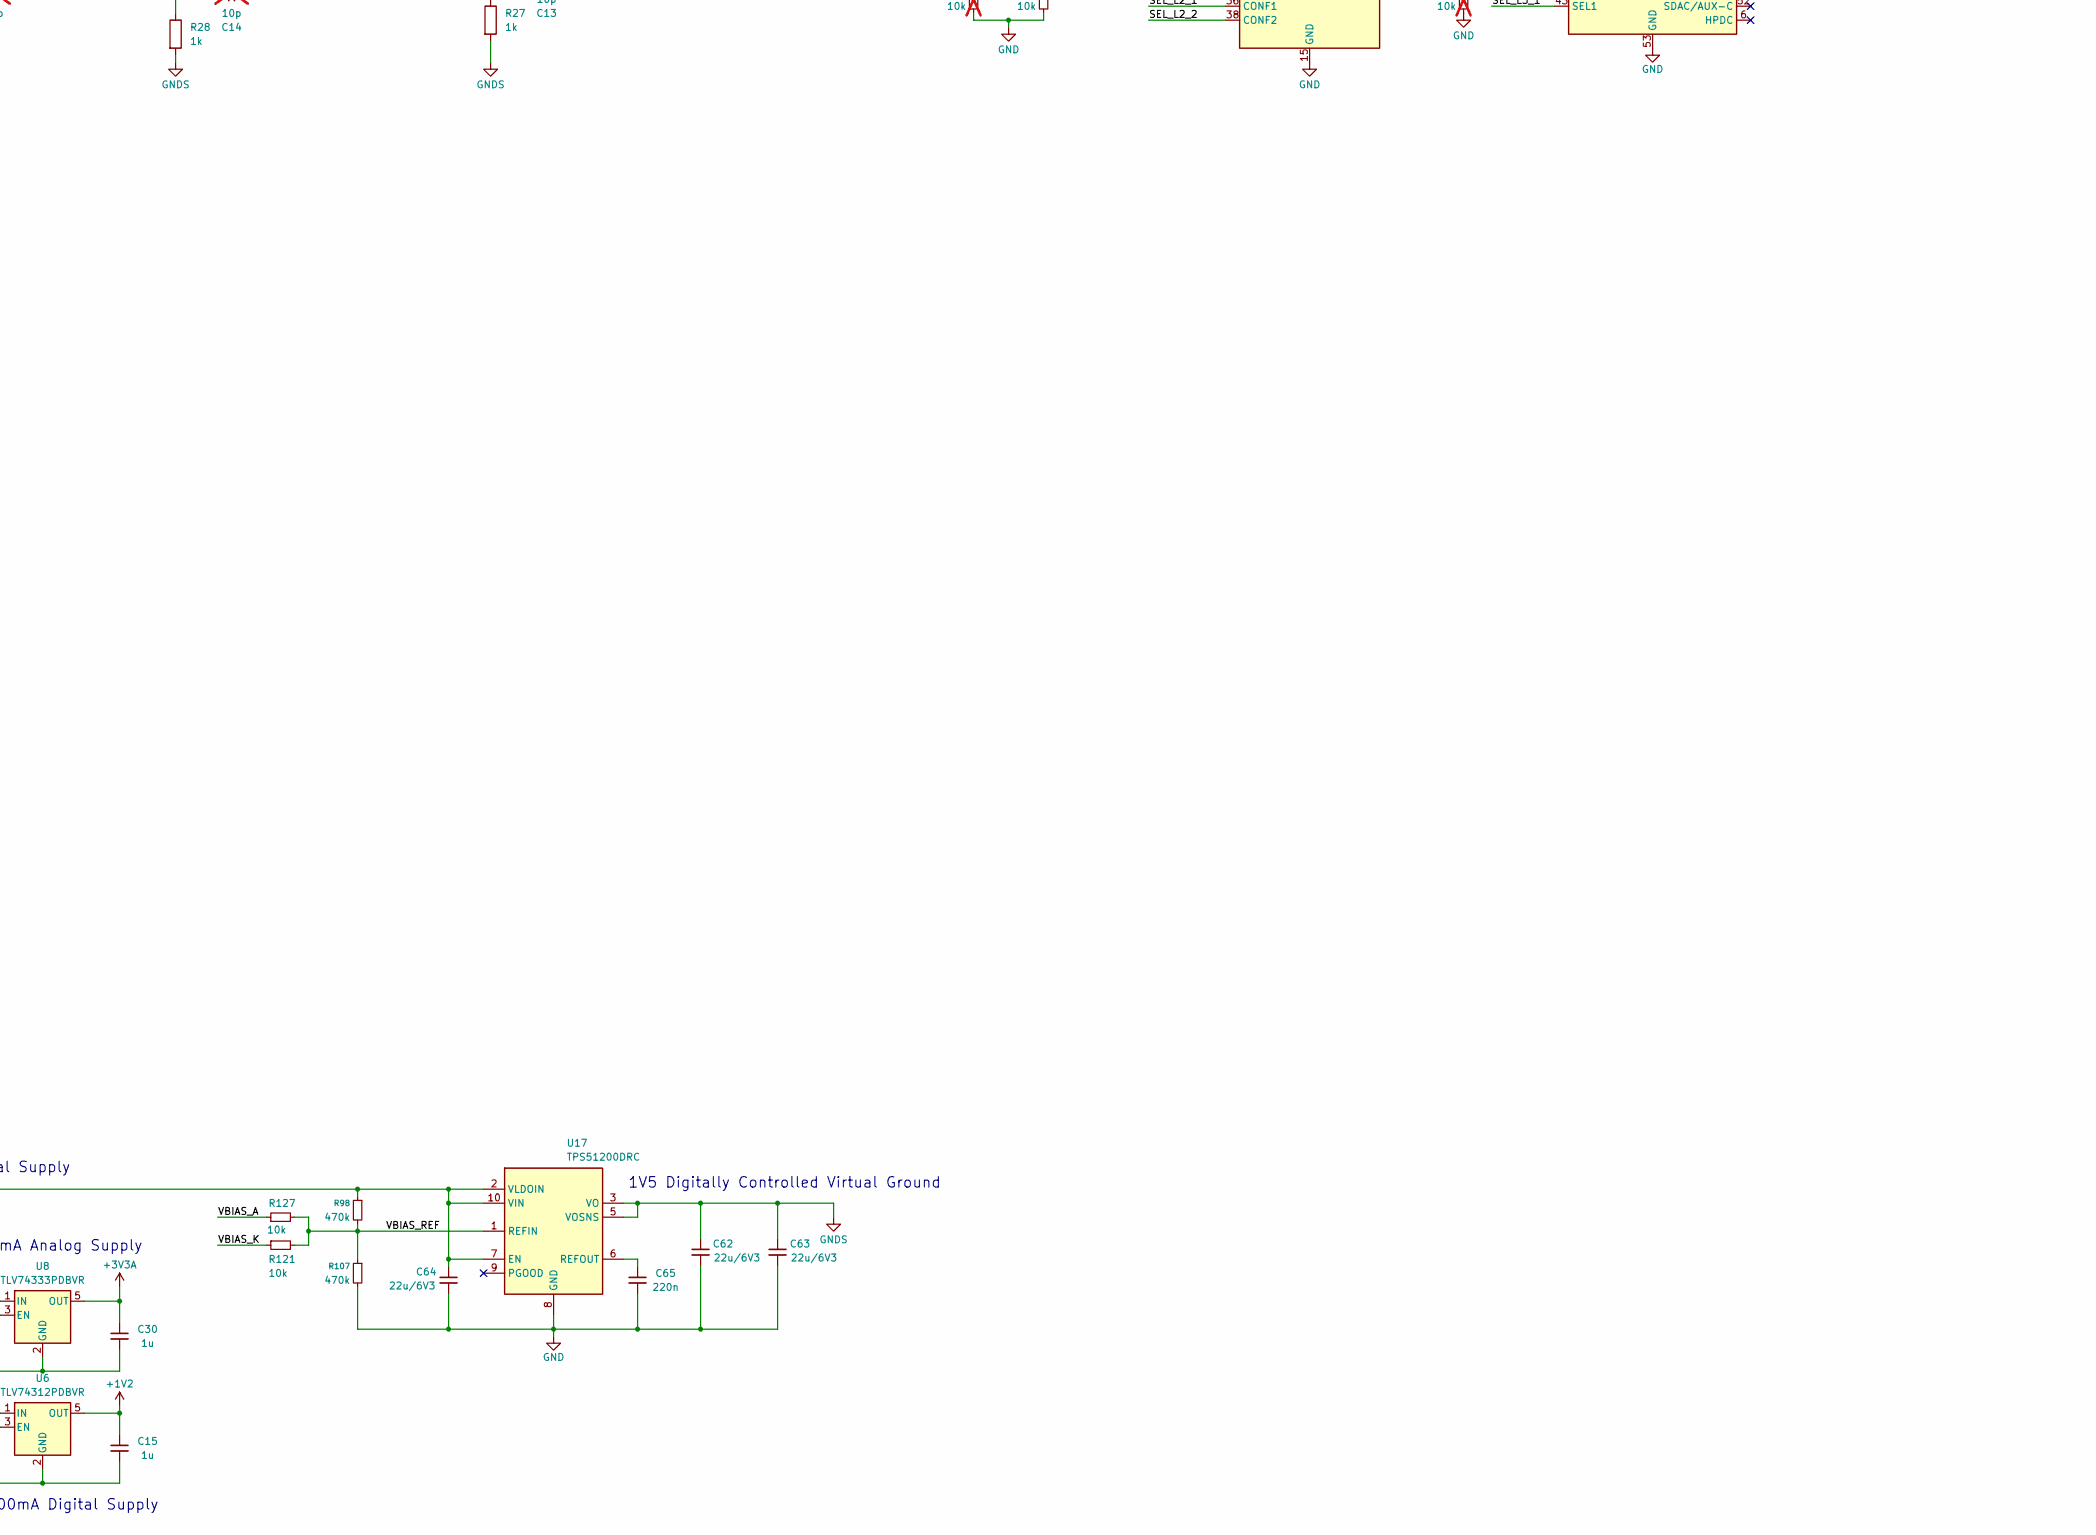
[picture p7: schematic yanartas-pillowbox-sensing.kicad_sch, part in row 2, column 2]

Parts:
C1, C2, C3, C4, C5, C6, C7, C8, C10, C11, C24, C42, C43, C50, C51, C52, C53, C54, C55, C56, C61, C65, C66, C67, C68, C71, C72, C73, C74, C75, C76: 220n; C_0402_1005Metric; LCSC C16772
C9, C12, C13, C14: 10p; C_0402_1005Metric; LCSC C32949; not fitted
C15, C16, C18, C19, C20, C21, C22, C23, C25, C30, C35, C36, C37, C41, C44, C45, C46, C49, C57, C58, C59, C60, C77, C78, C79, C80, C81, C82, C83, C84, C85, C86, C87, C91, C92: 1u; C_0402_1005Metric; LCSC C52923
C17, C31, C33: 22p; C_0402_1005Metric; LCSC C1555
C26, C27: 10u/10V; C_0603_1608Metric; LCSC C96446
C28: 22u/10V; C_0805_2012Metric; LCSC C45783
C29, C32, C34, C62, C63, C64, C88: 22u/6V3; C_0805_2012Metric; LCSC C45783
C39, C40: 10p; C_0402_1005Metric; LCSC C32949
C69, C70: 1n; C_0402_1005Metric; LCSC C1523
C89: 100n; C_0402_1005Metric; LCSC C1525
C90: 4u7/10V; C_0402_1005Metric; LCSC C23733
D1, D2, D3, D4, D5, D6, D7, D8: BAT15-04W; SOT-323_SC-70; LCSC C5380972
D12, D13, D14: LED; LED_0603_1608Metric; LCSC C2290
J1, J2, J19: FH12S-30S-0.5SH(55); Hirose_FH12-30S-0.5SH_1x30-1MP_P0.50mm_Horizontal; LCSC C3169607
J3: Wuerth WR-WST Redfit IDC; Würth_WR-WST_debug_490107671612_2x08_P2.54mm_Vertical; LCSC NA
J5: USB_C_Receptacle_USB2.0_16P; USB_C_Receptacle_HRO_TYPE-C-31-M-12; LCSC C165948; not fitted
L1, L2, L3: 2u2; CJIANG_FXL0420; LCSC C167206
R1, R2, R31, R32, R42, R43: 100; R_0402_1005Metric; LCSC C25076
R3, R4, R5, R6, R17, R18, R19, R20: 91; R_0402_1005Metric; LCSC C270574
R7, R8, R9, R10, R11, R12, R13, R14, R15, R16, R21, R22: 16; R_0402_1005Metric; LCSC C227309
R23, R25, R27, R28, R51, R99, R102, R103, R104, R124, R125: 1k; R_0402_1005Metric; LCSC C11702
R24, R26, R29, R30: 3k3; R_0402_1005Metric; LCSC C25890
R33, R35, R37, R48: 100k; R_0402_1005Metric; LCSC C25741
R34: 22k1; R_0402_1005Metric; LCSC C43473
R36: 18k2; R_0402_1005Metric; LCSC C25859
R38: 49k9; R_0402_1005Metric; LCSC C25897
R44, R46, R56, R58, R59, R74, R76, R77, R92, R93, R100, R101, R119, R121, R126, R127: 10k; R_0402_1005Metric; LCSC C25744
R45, R47, R52, R53, R57, R75: 10k; R_0402_1005Metric; LCSC C25744; not fitted
R49, R50: 5k1; R_0402_1005Metric; LCSC C25905
R54: 0; R_0402_1005Metric; LCSC C17168
R55: 0; R_0402_1005Metric; LCSC C17168; not fitted
R60, R61, R62, R63, R64, R65, R67, R68, R70, R71, R72, R109, R111, R114, R116, R118: 4k7; R_0402_1005Metric; LCSC C25900; not fitted
R66, R69, R73, R105, R106, R110, R112, R113, R115, R117: 4k7; R_0402_1005Metric; LCSC C25900
R78, R79, R80, R81, R82, R83, R84, R85: 10; R_0402_1005Metric; LCSC C25077
R94, R95, R96, R97: 47k; R_0402_1005Metric; LCSC C25792
R98, R107: 470k; R_0402_1005Metric; LCSC C25790
R122, R123: 3k9; R_0402_1005Metric; LCSC C51721
T12, T13, T14, T15: 100ps; LCSC NA
TP22: IOR7A; TestPoint_Pad_D1.0mm; LCSC NA
TP23: IOR7B; TestPoint_Pad_D1.0mm; LCSC NA
TP24: PB6; TestPoint_Pad_D1.0mm; LCSC NA
TP25: PB7; TestPoint_Pad_D1.0mm; LCSC NA
U2: PI3HDX12311; Diodes_XEA32_X1-QFN-32-1EP_2.85x4.5mm_P0.4mm_EP1.75x3.4mm; Digikey 31-PI3HDX12311XEAEXCT-ND
U3, U9: PI3WVR41310; Diodes_ZL52_TQFN-52-1EP_3.5x9mm_P0.4mm_EP2x7.5mm; Digikey 31-PI3WVR41310ZLEXCT-ND
U4, U12: TMUXHS4446; Texas_WQFN-40-1EP_3x6mm_P0.4mm_EP1.7x4.5mm; Digikey 296-TMUXHS4446IRETRCT-ND
U5: GW1NZ-LV1QN48C6; Gowin_QN48_QFN-48-1EP_6x6mm_P0.4mm_EP4.3x4.3mm; LCSC C5799569
U6: TLV74312PDBVR; SOT-23-5; LCSC C485149
U7: TMI7003C; QFN-20-1EP_3x3mm_P0.4mm_EP1.7x1.7mm; LCSC C840566
U8: TLV74333PDBVR; SOT-23-5; LCSC_Alt C408972
U10: TMUXHS4212; Texas_RKS0020A_VQFN-20-1EP_2.5x4.5mm_P0.5mm_EP1x3mm; LCSC C2869871
U13: OPA4354; TSSOP-14_4.4x5mm_P0.65mm; LCSC C527494
U15: STM32U575RGTx; LQFP-64_10x10mm_P0.5mm; Digikey 497-STM32U575RGT6TRCT-ND
U16: USBLC6-4SC6; SOT-23-6; LCSC C558419
U17: TPS51200DRC; VSON-10-1EP_3x3mm_P0.5mm_EP1.65x2.4mm; LCSC C34771
Y1: 16MHz 10p; Crystal_SMD_3225-4Pin_3.2x2.5mm; LCSC C13738

Connections:
+1V2: C15.2, C25.2, R54.1, U5.12 (VCC), U5.37 (VCC), U6.5 (OUT)
+1V8: C16.2, C34.2, L3.2, R37.1, U6.1 (IN), U6.3 (EN)
+3V3A: C30.2, C35.2, C46.2, U8.5 (OUT), U13.4 (V+), U15.13 (VDDA)
+3V3D: C19.2, C20.2, C21.2, C22.2, C23.2, C29.2, C36.2, C37.2, C41.2, C44.2, C45.2, C57.2, C59.2, C60.2, C64.2, C77.2, C78.2, C79.2, C80.2, C81.2, C82.2, C83.2, C84.2, C85.2, C86.2, C87.2, C88.2, C91.2, C92.2, J19.5, J19.26, L1.2, R33.1, R44.1, R46.1, R51.1, R52.1, R53.1, R55.2, R56.1, R58.1, R60.1, R62.1, R64.1, R66.1, R68.1, R70.1, R72.1, R74.1, R76.1, R98.1, R105.2, R106.2, R109.1, R111.1, R113.1, R115.1, R117.1, R122.1, R123.1, R124.1, R125.1, R126.2, U2.3 (VDD), U2.6 (VDD), U2.9 (VDD), U2.22 (VDD), U3.42 (VDD), U4.4 (VCC), U4.7 (VCC), U4.10 (VCC), U4.23 (VCC), U4.26 (VCC), U4.29 (VCC), U4.32 (VCC), U5.1 (VCCIO0), U5.36 (VCCX), U9.42 (VDD), U10.1 (RSVD1), U10.6 (VCC), U10.10 (RSVD2), U12.4 (VCC), U12.7 (VCC), U12.10 (VCC), U12.23 (VCC), U12.26 (VCC), U12.29 (VCC), U12.32 (VCC), U15.1 (VBAT), U15.19 (VDD), U15.32 (VDD), U15.48 (VDDUSB), U15.64 (VDD), U17.2 (VLDOIN), U17.7 (EN), U17.10 (VIN)
+5V: C26.2, C27.2, C28.2, J3.1, J5.A4 (VBUS), J5.A9 (VBUS), J5.B4 (VBUS), J5.B9 (VBUS), J19.2, J19.3, J19.28, J19.29, U7.7 (VIN2), U7.8 (EN2), U7.9 (EN1), U7.10 (VIN1), U7.18 (EN3), U7.19 (VIN3), U16.5 (VBUS)
/+3V9_INTERMEDIATE: C18.2, C32.2, L2.2, R35.1, U8.1 (IN), U8.3 (EN)
/BOOT0: R119.1, U15.60 (PH3)
/DBG1: J3.12, U15.50 (PA15)
/DBG2: J3.5, U5.6 (IOT9A/SCLK/SPMI_CLK)
/FPGA_CFG: U5.35 (IOT17B), U15.39 (PC8)
/FPGA_CLK: U5.47 (IOT10A/GCLKT_0), U15.41 (RCC_MCO)
/FPGA_DONE: R113.2, R114.1, U5.46 (IOT12A/DONE), U15.25 (PC5)
/FPGA_MODE0: R111.2, R112.1, U5.43 (IOT14A/MODE0)
/FPGA_MODE1: R109.2, R110.1, U5.42 (IOT14B/MODE1)
/FPGA_READY: R115.2, R116.1, U5.45 (IOT12B/READY)
/FPGA_RECONFIG_N: R117.2, R118.1, U5.48 (IOT9B/RECONFIG_N), U15.24 (PC4)
/FPGA_RST: U5.38 (IOT17A), U15.38 (PC7)
/FPGA_RX: U5.40 (IOT16A), U15.52 (USART3_RX)
/FPGA_SCK: U5.8 (IOT10B/GCLKC_0), U15.53 (USART3_CK)
/FPGA_TCK: J3.7, U5.3 (IOT7B/TCK/SPMI_EN/VCCEN), U15.8 (PC0)
/FPGA_TDI: J3.11, U5.5 (IOT8A/TDI/SPMI_SCLK), U15.10 (PC2)
/FPGA_TDO: J3.13, U5.7 (IOT8B/TDO), U15.11 (PC3)
/FPGA_TMS: J3.9, U5.4 (IOT7A/TMS/SPMI_SDATA), U15.9 (PC1)
/FPGA_TRIG: U5.39 (IOT16B), U15.37 (TIM3_CH1)
/FPGA_TX: U5.41 (IOT15B), U15.51 (USART3_TX)
/HOST_ALM: J19.18, U15.40 (PC9)
/HOST_ALMn: J19.17, U15.2 (PC13)
/HOST_HIPO: J19.7, U15.35 (SPI2_MISO)
/HOST_HOPI: J19.10, U15.36 (SPI2_MOSI)
/HOST_RX: J19.13, R42.2, U15.43 (USART1_RX)
/HOST_SCK: J19.8, U15.34 (SPI2_SCK)
/HOST_TX: J19.14, R43.2, U15.42 (USART1_TX)
/HOST_nCS: J19.11, U15.33 (SPI2_NSS)
/HSE_IN: C40.2, U15.5 (RCC_OSC_IN), Y1.1
/HSE_OUT: C39.2, U15.6 (RCC_OSC_OUT), Y1.3
/LED1: D12.1 (K), U15.16 (PA2)
/LED2: D13.1 (K), U15.29 (PB10)
/LED3: D14.1 (K), U15.54 (PD2)
/OUT_MUX1_OE: R44.2, R45.1, U3.5 (OE)
/OUT_MUX2_OE: R46.2, R47.1, U9.5 (OE)
/PMIC_ENABLE: J19.24, U15.21 (PA5)
/REDRV_EQHS: R68.2, R69.1, U2.13 (EQHS)
/REDRV_EQLS: R70.2, R71.1, U2.12 (EQLS)
/REDRV_FG: R66.2, R67.1, U2.28 (FG)
/REDRV_HPD: R48.2, U15.57 (PB5)
/REDRV_MODE: R72.2, R73.1, U2.16 (MODE)
/REDRV_N1SW0: R62.2, R63.1, U2.25 (N1SW0)
/REDRV_N1SW1: R60.2, R61.1, U2.29 (N1SW1)
/REDRV_SW: R64.2, R65.1, U2.15 (SW)
/RET_100N: J1.10, U3.35 (D3NA)
/RET_100P: J1.9, U3.34 (D3PA)
/RET_101N: J1.20, U3.27 (D3NB)
/RET_101P: J1.19, U3.26 (D3PB)
/RET_102N: J1.30, U3.19 (D3NC)
/RET_102P: J1.29, U3.18 (D3PC)
/RET_110N: J2.10, U9.35 (D3NA)
/RET_110P: J2.9, U9.34 (D3PA)
/RET_111N: J2.20, U9.27 (D3NB)
/RET_111P: J2.19, U9.26 (D3PB)
/RET_112N: J2.30, U9.19 (D3NC)
/RET_112P: J2.29, U9.18 (D3PC)
/RET_200N: J1.5, U3.39 (D1NA)
/RET_200P: J1.4, U3.38 (D1PA)
/RET_201N: J1.15, U3.31 (D1NB)
/RET_201P: J1.14, U3.30 (D1PB)
/RET_202N: J1.25, U3.23 (D1NC)
/RET_202P: J1.24, U3.22 (D1PC)
/RET_210N: J2.5, U9.39 (D1NA)
/RET_210P: J2.4, U9.38 (D1PA)
/RET_211N: J2.15, U9.31 (D1NB)
/RET_211P: J2.14, U9.30 (D1PB)
/RET_212N: J2.25, U9.23 (D1NC)
/RET_212P: J2.24, U9.22 (D1PC)
/SAMPLE_ADC1N: C9.2, R24.2, U13.7, U15.23 (ADC1_IN12)
/SAMPLE_ADC1P: C12.2, R26.2, U13.1, U15.22 (ADC1_IN11)
/SAMPLE_ADC2N: C13.2, R29.2, U13.14, U15.15 (ADC1_IN6)
/SAMPLE_ADC2P: C14.2, R30.2, U13.8, U15.14 (ADC1_IN5)
/SEL_L1: U10.9 (SEL), U15.28 (PB2)
/SEL_L2_0: U4.35 (CONF0), U12.35 (CONF0), U15.27 (PB1)
/SEL_L2_1: R122.2, U4.36 (CONF1), U12.36 (CONF1), U15.61 (I2C1_SCL)
/SEL_L2_2: R123.2, U4.38 (CONF2), U12.38 (CONF2), U15.62 (I2C1_SDA)
/SEL_L3_0: R126.1, U3.44 (SEL0), U9.44 (SEL0), U15.55 (PB3)
/SEL_L3_1: U3.43 (SEL1), U9.43 (SEL1), U15.56 (PB4)
/SEND_100N: J1.8, U3.37 (D2NA)
/SEND_100P: J1.7, U3.36 (D2PA)
/SEND_101N: J1.18, U3.29 (D2NB)
/SEND_101P: J1.17, U3.28 (D2PB)
/SEND_102N: J1.28, U3.21 (D2NC)
/SEND_102P: J1.27, U3.20 (D2PC)
/SEND_110N: J2.8, U9.37 (D2NA)
/SEND_110P: J2.7, U9.36 (D2PA)
/SEND_111N: J2.18, U9.29 (D2NB)
/SEND_111P: J2.17, U9.28 (D2PB)
/SEND_112N: J2.28, U9.21 (D2NC)
/SEND_112P: J2.27, U9.20 (D2PC)
/SEND_200N: J1.3, U3.41 (D0NA)
/SEND_200P: J1.2, U3.40 (D0PA)
/SEND_201N: J1.13, U3.33 (D0NB)
/SEND_201P: J1.12, U3.32 (D0PB)
/SEND_202N: J1.23, U3.25 (D0NC)
/SEND_202P: J1.22, U3.24 (D0PC)
/SEND_210N: J2.3, U9.41 (D0NA)
/SEND_210P: J2.2, U9.40 (D0PA)
/SEND_211N: J2.13, U9.33 (D0NB)
/SEND_211P: J2.12, U9.32 (D0PB)
/SEND_212N: J2.23, U9.25 (D0NC)
/SEND_212P: J2.22, U9.24 (D0PC)
/SPL_HS_1N: D3.3 (common), R10.1
/SPL_HS_1P: D2.3 (common), R9.1
/SPL_HS_2N: D7.3 (common), R22.1
/SPL_HS_2P: D6.3 (common), R21.1
/SPL_LS_1N: D4.3 (common), U13.5 (+)
/SPL_LS_1P: D1.3 (common), U13.3 (+)
/SPL_LS_2N: D8.3 (common), U13.12 (+)
/SPL_LS_2P: D5.3 (common), U13.10 (+)
/STIM_1N_A: R79.1, U5.10 (IOR2B)
/STIM_1N_B: C2.1, U2.26 (A_TXN)
/STIM_1N_C: C2.2, R11.1
/STIM_1N_R: C51.1, R79.2
/STIM_1N_RC: C51.2, U2.2 (A_RXN)
/STIM_1P_A: R78.1, U5.9 (IOR2A)
/STIM_1P_B: C1.1, U2.27 (A_TXP)
/STIM_1P_C: C1.2, R7.1
/STIM_1P_R: C24.1, R78.2
/STIM_1P_RC: C24.2, U2.1 (A_RXP)
/STIM_2N_A: R81.1, U5.34 (IOR3B)
/STIM_2N_B: C4.1, U2.23 (B_TXN)
/STIM_2N_C: C4.2, R13.1
/STIM_2N_R: C52.1, R81.2
/STIM_2N_RC: C52.2, U2.5 (B_RXN)
/STIM_2P_A: R80.1, U5.11 (IOR3A)
/STIM_2P_B: C3.1, U2.24 (B_TXP)
/STIM_2P_C: C3.2, R14.1
/STIM_2P_R: C50.1, R80.2
/STIM_2P_RC: C50.2, U2.4 (B_RXP)
/STROBE_1N_A: R85.1, U5.13 (IOR10B)
/STROBE_1N_B: C8.1, U2.17 (D_TXN)
/STROBE_1N_C: C8.2, R3.1, R5.1, T13.1
/STROBE_1N_R: C56.1, R85.2
/STROBE_1N_RC: C56.2, U2.11 (D_RXN)
/STROBE_1P_A: R84.1, U5.20 (IOR10A)
/STROBE_1P_B: C7.1, U2.18 (D_TXP)
/STROBE_1P_C: C7.2, R4.2, R6.2, T12.1
/STROBE_1P_R: C55.1, R84.2
/STROBE_1P_RC: C55.2, U2.10 (D_RXP)
/STROBE_2N_A: R83.1, U5.23 (IOR8B)
/STROBE_2N_B: C6.1, U2.20 (C_TXN)
/STROBE_2N_C: C6.2, C70.1, C72.1, C75.2, R17.1, R19.1, R103.1, T14.1, T14.3
/STROBE_2N_R: C54.1, R83.2
/STROBE_2N_RC: C54.2, U2.8 (C_RXN)
/STROBE_2P_A: R82.1, U5.24 (IOR8A)
/STROBE_2P_B: C5.1, U2.21 (C_TXP)
/STROBE_2P_C: C5.2, C70.2, C72.2, C76.2, R18.2, R20.2, R104.1, T15.1, T15.3
/STROBE_2P_R: C53.1, R82.2
/STROBE_2P_RC: C53.2, U2.7 (C_RXP)
/TDR_1N: C66.2, R95.1, U10.4 (A0n)
/TDR_1N_CPL: C66.1, R12.2
/TDR_1P: C61.2, R94.1, U10.3 (A0p)
/TDR_1P_CPL: C61.1, R8.2
/TDR_2N: C67.2, R97.2, U10.8 (A1n)
/TDR_2N_CPL: C67.1, R15.2
/TDR_2P: C68.2, R96.2, U10.7 (A1p)
/TDR_2P_CPL: C68.1, R16.2
/TERM_MUX1_A0: R56.2, R57.1, U4.14 (A0)
/TERM_MUX1_MODE0: R52.2, R59.1, U4.1 (MODE0)
/TERM_MUX1_MODE1: R58.2, U4.13 (MODE1)
/TERM_MUX2_A0: R74.2, R75.1, U12.14 (A0)
/TERM_MUX2_MODE0: R53.2, R77.1, U12.1 (MODE0)
/TERM_MUX2_MODE1: R76.2, U12.13 (MODE1)
/TERM_S_10N: C11.2, U4.17 (SSRX-)
/TERM_S_10P: C11.1, U4.16 (SSRX+)
/TERM_S_11N: C43.2, U12.17 (SSRX-)
/TERM_S_11P: C43.1, U12.16 (SSRX+)
/TERM_S_20N: C10.1, U4.12 (SSTX-)
/TERM_S_20P: C10.2, U4.11 (SSTX+)
/TERM_S_21N: C42.1, U12.12 (SSTX-)
/TERM_S_21P: C42.2, U12.11 (SSTX+)
/TERM_Z_10N: R2.2, U4.9 (DP3-)
/TERM_Z_10P: R2.1, U4.8 (DP3+)
/TERM_Z_11N: R32.2, U12.9 (DP3-)
/TERM_Z_11P: R32.1, U12.8 (DP3+)
/TERM_Z_20N: R1.1, U4.6 (DP2-)
/TERM_Z_20P: R1.2, U4.5 (DP2+)
/TERM_Z_21N: R31.1, U12.6 (DP2-)
/TERM_Z_21P: R31.2, U12.5 (DP2+)
/UC_NRST: C89.2, J3.14, U15.7 (NRST)
/UC_SWCLK: J3.10, U15.49 (DEBUG_JTCK-SWCLK)
/UC_SWDIO: J3.8, U15.46 (DEBUG_JTMS-SWDIO)
/USB_DM: J5.A7 (D-), J5.B7 (D-), U15.44 (USB_OTG_FS_DM), U16.1 (I/O1), U16.6 (I/O4)
/USB_DP: J5.A6 (D+), J5.B6 (D+), U15.45 (USB_OTG_FS_DP), U16.3 (I/O2), U16.4 (I/O3)
/VBIAS_A: R102.2, R103.2, R127.1, U15.17 (OPAMP1_VOUT)
/VBIAS_K: R99.2, R104.2, R121.1, U15.26 (OPAMP2_VOUT)
/VBIAS_REF: R98.2, R107.1, R121.2, R127.2, U17.1 (REFIN)
/~OUT_ACT: J19.20, U15.3 (PC14)
/~OUT_ALARM: J19.21, U15.20 (PA4)
/~OUT_SECURE: J19.23, U15.4 (PC15)
GND: C15.1, C16.1, C17.2, C18.1, C19.1, C20.1, C21.1, C22.1, C23.1, C25.1, C26.1, C27.1, C28.1, C29.1, C30.1, C31.2, C32.1, C33.2, C34.1, C35.1, C36.1, C37.1, C39.1, C40.1, C41.1, C44.1, C45.1, C46.1, C49.1, C57.1, C58.1, C59.1, C60.1, C62.1, C63.1, C64.1, C65.1, C73.1, C74.1, C75.1, C76.1, C77.1, C78.1, C79.1, C80.1, C81.1, C82.1, C83.1, C84.1, C85.1, C86.1, C87.1, C88.1, C89.1, C90.2, C91.1, C92.1, J1.1, J1.6, J1.11, J1.16, J1.21, J1.26, J1.MP (MountPin), J2.1, J2.6, J2.11, J2.16, J2.21, J2.26, J2.MP (MountPin), J3.3, J3.6, J3.15, J3.16, J5.A1 (GND), J5.A12 (GND), J5.B1 (GND), J5.B12 (GND), J5.SH (SHIELD), J19.1, J19.4, J19.6, J19.9, J19.12, J19.15, J19.16, J19.19, J19.22, J19.25, J19.27, J19.30, J19.MP (MountPin), R34.2, R36.2, R38.2, R45.2, R47.2, R49.2, R50.2, R57.2, R59.2, R61.2, R63.2, R65.2, R67.2, R69.2, R71.2, R73.2, R75.2, R77.2, R107.2, R110.2, R112.2, R114.2, R116.2, R118.2, R119.2, T12.2, T12.4, T13.2, T13.4, T14.2, T14.4, T15.2, T15.4, U2.14 (GND), U2.30 (GND), U2.33 (GND), U3.53 (GND), U4.15 (GND), U4.18 (GND), U4.37 (GND), U4.41 (GND), U5.2 (VSS), U5.26 (VSS), U5.44 (IOT13A/JTAGSEL_N), U5.49 (VSS), U6.2 (GND), U7.21 (GND), U8.2 (GND), U9.53 (GND), U10.2 (OEn), U10.5 (GND), U10.11 (GND), U10.20 (GND), U10.21 (GND), U12.15 (GND), U12.18 (GND), U12.37 (GND), U12.41 (GND), U13.11 (V-), U15.12 (VSSA), U15.18 (VSS), U15.31 (VSS), U15.47 (VSS), U15.63 (VSS), U16.2 (GND), U17.4 (GND), U17.8 (GND), U17.11 (GND), Y1.2 (G), Y1.4 (G)
GNDS: C58.2, C62.2, C63.2, R23.2, R25.2, R27.2, R28.2, R92.2, R93.2, R94.2, R95.2, R96.1, R97.1, R100.2, R101.2, U17.3 (VO), U17.5 (VOSNS)
unnamed: C69.1, C71.1, C74.2, R102.1, T13.3
unnamed: C69.2, C71.2, C73.2, R99.1, T12.3
unnamed: D1.1 (A), D2.1 (A), R5.2
unnamed: D1.2 (K), D2.2 (K), R4.1
unnamed: D3.1 (A), D4.1 (A), R3.2
unnamed: D3.2 (K), D4.2 (K), R6.1
unnamed: D5.1 (A), D6.1 (A), R17.2
unnamed: D5.2 (K), D6.2 (K), R18.1
unnamed: D7.1 (A), D8.1 (A), R19.2
unnamed: D7.2 (K), D8.2 (K), R20.1
unnamed: D12.2 (A), R51.2
unnamed: D13.2 (A), R124.2
unnamed: D14.2 (A), R125.2
unnamed: J3.2, R43.1
unnamed: J3.4, R42.1
unnamed: J5.A5 (CC1), R49.1
unnamed: J5.B5 (CC2), R50.1
unnamed: R7.2, R8.1, R9.2, R92.1
unnamed: R10.2, R11.2, R12.1, R93.1
unnamed: R14.2, R16.1, R21.2, R100.1
unnamed: R13.2, R15.1, R22.2, R101.1
unnamed: R106.1, U2.32 (DDC_SCL)
unnamed: R105.1, U2.31 (DDC_SDA)
unnamed: R48.1, U2.19 (HPD)
unnamed: U3.10 (D0N), U4.27 (CTX1-)
unnamed: U3.11 (D0P), U4.28 (CTX1+)
unnamed: U3.12 (D1N), U4.30 (CTX2-)
unnamed: U3.13 (D1P), U4.31 (CTX2+)
unnamed: U3.14 (D2N), U4.24 (CRX1-)
unnamed: U3.15 (D2P), U4.25 (CRX1+)
unnamed: U3.16 (D3N), U4.33 (CRX2-)
unnamed: U3.17 (D3P), U4.34 (CRX2+)
unnamed: TP22.1 (1_1), U5.27 (IOR7A)
unnamed: TP23.1 (1_1), U5.21 (IOR7B)
unnamed: C49.2, R54.2, R55.1, U5.25 (VCCIO1)
unnamed: C17.1, R33.2, R34.1, U7.14 (FB1)
unnamed: C31.1, R35.2, R36.1, U7.3 (FB2)
unnamed: C33.1, R37.2, R38.1, U7.2 (FB3)
unnamed: L1.1, U7.11 (LX1)
unnamed: L2.1, U7.6 (LX2)
unnamed: L3.1, U7.20 (LX3)
unnamed: U10.12 (C1n), U12.3 (DP1-)
unnamed: U10.13 (C1p), U12.2 (DP1+)
unnamed: U10.14 (C0n), U12.40 (DP0-)
unnamed: U10.15 (C0p), U12.39 (DP0+)
unnamed: U4.3 (DP1-), U10.16 (B1n)
unnamed: U4.2 (DP1+), U10.17 (B1p)
unnamed: U4.40 (DP0-), U10.18 (B0n)
unnamed: U4.39 (DP0+), U10.19 (B0p)
unnamed: U9.14 (D2N), U12.24 (CRX1-)
unnamed: U9.15 (D2P), U12.25 (CRX1+)
unnamed: U9.10 (D0N), U12.27 (CTX1-)
unnamed: U9.11 (D0P), U12.28 (CTX1+)
unnamed: U9.12 (D1N), U12.30 (CTX2-)
unnamed: U9.13 (D1P), U12.31 (CTX2+)
unnamed: U9.16 (D3N), U12.33 (CRX2-)
unnamed: U9.17 (D3P), U12.34 (CRX2+)
unnamed: C12.1, R25.1, R26.1, U13.2 (-)
unnamed: C9.1, R23.1, R24.1, U13.6 (-)
unnamed: C14.1, R28.1, R30.1, U13.9 (-)
unnamed: C13.1, R27.1, R29.1, U13.13 (-)
unnamed: TP24.1 (1_1), U15.58 (PB6)
unnamed: TP25.1 (1_1), U15.59 (PB7)
unnamed: C90.1, U15.30 (VCAP)
unnamed: C65.2, U17.6 (REFOUT)

Notes on the sheet:
Selects termination, and flips mesh send/return
to µC ADC
3V3/500mA Digital Supply
Place clip line close to diodes
Signal Splitter
Stimulus & Sampling Pulse Timing Generation
Sub-Mesh Output Mux
Debug connector
Power Supplies
PB10
Sampling Bridges
Pulse Amplifier
PA2
TODO: ESD diodes here?
Debug USB
1V2/100mA Digital Supply
1V5 Digitally Controlled Virtual Ground
Low-Speed Amplifiers
FPGA
Termination Mux & Crossbar
3V3/100mA Analog Supply
Clip Lines
Microcontroller
L/R Connector Mux
Couples incident stimulus into mesh, reflections into sampler
PD2
J19: board-to-board link to the power PCB, Hirose FH12S-30S-0.5SH(55), 30 pos 0.5 mm FFC. Cable: same-side contacts (type A) FFC, both connectors on the top side facing each other: conductor on pin k of the power PCB connector lands on pin 31-k of the sensing PCB connector. The two schematics alrea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
+5V / GND supplied by the power PCB through J19

Board: 2 copper layers, 234 parts (0 on the bottom side), 120 nets, no tracks yet.
