jaseg/yanartas-sensors/(commit log)

2026-11-04 Schematics WIP, working on sampling bridge topo
    [yanartas-pillowbox-sensors.kicad_sch]
2026-11-04 Fix sampling bridge biasing
    Move both P/N sampling bridges to the same polarity. This allows us to
    use the STM32's ADC's differential input mode, and it simplifies
    biasing. With both sampling bridges in the same direction, we can bias
    them through the far ends of the clip lines.
    Also calc out initial values for the redriver pin straps.
    [yanartas-pillowbox-sensors.kicad_sch]
2026-11-04 Small schematic bug fixes
    Fix Pi CS signal, route JTAG to STM32 just in case
    [yanartas-pillowbox-sensors.kicad_sch]
2026-11-06 WIP before deleting TI DCDC
    [yanartas-pillowbox-sensors.kicad_sch]
2026-11-06 RPi CM4/5 integration WIP
    [yanartas-pillowbox-sensors.kicad_sch]
2026-11-09 Schematic mostly done
2026-11-09 Finish footprint association
    [yanartas-pillowbox-sensors.kicad_pcb, yanartas-pillowbox-sensors.kicad_sch]
2026-11-09 Floor planning WIP
    [yanartas-pillowbox-sensors.kicad_pcb, yanartas-pillowbox-sensors.kicad_sch]
2026-11-09 Fix input connector pinout for current load
    [yanartas-pillowbox-sensors.kicad_sch]
2026-11-09 Regenerate vendored QFN footprints with kicad-footprint-generator
    The footprints in HighSpeed_Interface.pretty, Gowin_FPGA.pretty and
    Power_Management.pretty were hand-written. Replace them with footprints and
    STEP models generated by the official KiCad footprint generator from
    package definitions transcribed from the manufacturer drawings
    (lib-src/kicad-footprint-generator_yanartas_custom.yaml):
    - Diodes XEA32 X1-QFN-32 (PI3HDX12311): land per datasheet p.25
    - Diodes ZL52 TQFN-52 (PI3WVR41310): exposed-pad land 2.0x7.5mm per
    the recommended land pattern (name now ..._EP2x7.5mm)
    - TI RKS0020A VQFN-20 (TMUXHS4212): per TI example board layout
    - Gowin QN48 (GW1NZ-1): pads/EP per UG843 recom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
2026-11-09 Register vendored libraries and point symbols at regenerated footprints
    - fp-lib-table: add HighSpeed_Interface, Gowin_FPGA and Power_Management
    footprint libraries (U2-U5, U7, U9, U10, U12 were missing from the PCB
    because these libraries were not registered).
    - sym-lib-table: add the project's components.kicad_sym.
    - Update footprint references in the schematic and the vendored symbol
    libraries to the regenerated footprint names. U4/U12 (TMUXHS4446,
    RET0040A) now use the stock KiCad
    Package_DFN_QFN:Texas_WQFN-40-1EP_3x6mm_P0.4mm_EP1.7x4.5mm.
    Claude-Session: https://claude.ai/code/session_013wvKop2FNPqU3ZDPYNupTd
    [yanartas-pillowbox-sensors.kicad_sch]
2026-11-09 EPCOS_B82723A: enlarge holes for 0.7x0.7 mm square pins
    TDK B82723A/J datasheet (Oct 2016): pins are 0.7 x 0.7 mm square
    (0.99 mm diagonal), so the 1.0 mm drill was too tight. Use 1.3 mm drill
    with 2.4 x 2.8 mm pads. Pin positions (15 x 25 mm) and numbering
    (windings 1-2 / 4-3) were checked and are correct.
    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
2026-11-09 Fix wrong LCSC part numbers and U13 footprint
    Checked every LCSC code against the LCSC product data:
    - R3-R6, R17-R20 (91R): C4147 is 91k -> C270574 (0402WGF910JTCE, 91R 1%)
    - R141-R143 (470R 0402): C23179 is an 0603 part -> C25117 (0402)
    - R36 (18k2): C25762 is 18k -> C25859 (18.2k 1%)
    - R34 (22k1): C25768 is 22k -> C43473 (22.1k 1%)
    - U13: C527494 is OPA4354AIPWR (TSSOP-14); the footprint was SOIC-14.
    Footprint changed to Package_SO:TSSOP-14_4.4x5mm_P0.65mm (the SOIC
    variant OPA4354AIDR has no LCSC/JLC stock).
    - U4/U12: add TMUXHS4446RETR C35471229 (low stock, see report).
    - Field clean-up: drop the duplicate "LCSC`" field on U1 and "LSCS" on U6;
    rename U8's "LSCS" (TI original C4089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
    [yanartas-pillowbox-sensors.kicad_sch]
2026-11-09 Split into power/processing and sensing projects with FH12 interconnect
    Two new KiCad projects, one per PCB, sharing the libraries in the repo
    root (lib tables point to ${KIPRJMOD}/../):
    - power/yanartas-pillowbox-power: everything placed inside the board
    outline (CM5, M.2, microSD, REC30K input stage, PoE/Ethernet magnetics,
    opto outputs, USB) plus the CM5 support parts that were still outside
    the outline: TP1-TP21, status LEDs D15/D16/D17 with R89/R136/R138,
    straps R87/R88/R90/R91/R137 and the SD card switch U14/C104/R135.
    - sensing/yanartas-pillowbox-sensing: everything else (TDR front end,
    FPGA, STM32, muxes, local supplies, J1/J2/J3/J5).
    Schematics: other-board symbols remov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
    [yanartas-pillowbox-power.kicad_pcb, yanartas-pillowbox-power.kicad_sch, yanartas-pillowbox-sensing.kicad_pcb, yanartas-pillowbox-sensing.kicad_sch]
2026-11-09 Add review notes for schematic, footprints, BOM and the board split
    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
2026-11-09 Remove the combined root project superseded by power/ and sensing/
    The single-board project files and the root-level library tables are
    replaced by the per-board projects in power/ and sensing/, which carry
    their own fp-lib-table/sym-lib-table. The shared libraries stay in the
    repository root.
    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
    [yanartas-pillowbox-sensors.kicad_pcb, yanartas-pillowbox-sensors.kicad_sch]
2026-11-09 Move all libraries into libraries/
    Moved footprints.pretty, Connector_Wuerth_WR_WST.pretty,
    HighSpeed_Interface/, Gowin_FPGA_KiCad/, components.kicad_sym and the
    generator sources lib-src/ from the repository root into libraries/.
    Updated every path that points at them:
    - power/ and sensing/ fp-lib-table and sym-lib-table
    (${KIPRJMOD}/../libraries/...), including the logo libraries that
    are still to be added;
    - 3D model paths in the library footprints and in the footprints
    embedded in the power PCB;
    - lib-src/README.md and REVIEW.md.
    Library nicknames are unchanged, so the schematics and PCBs need no
    other edits. ERC results for both projects are identical to before.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
    [yanartas-pillowbox-power.kicad_pcb]
